CASMPostol/CFIS/DIB/GS-CO.BMP

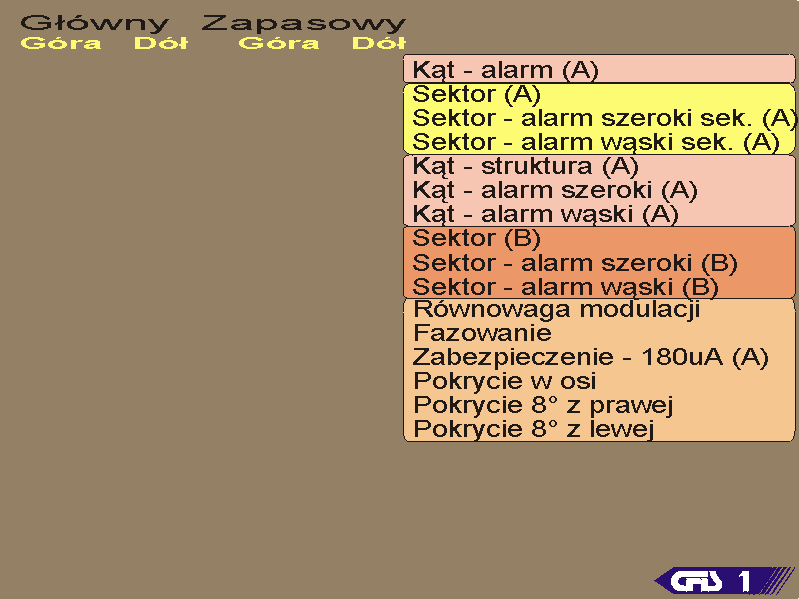
DIB/GS-CO.BMP
