CASMPostol/CFIS/DIB/LOC-CO.BMP

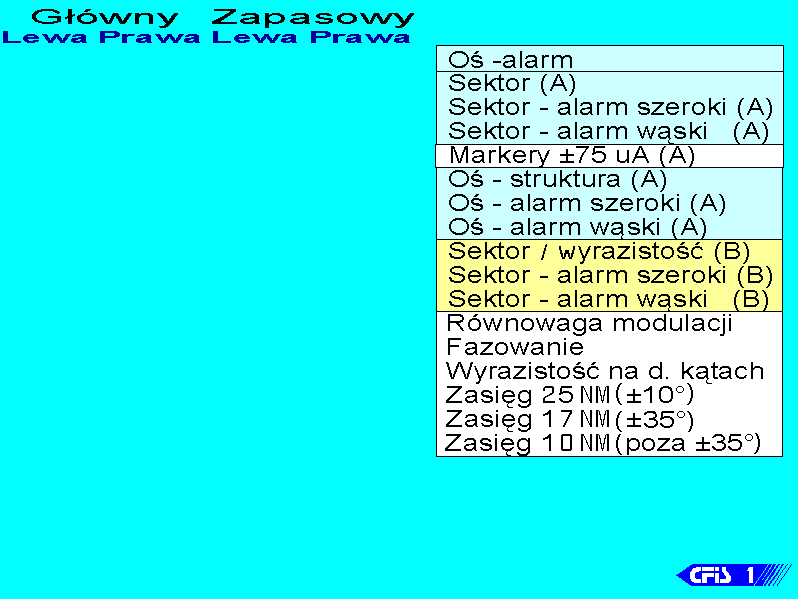
DIB/LOC-CO.BMP
