CASMPostol/CFIS/DIB/NDB-CO.BMP

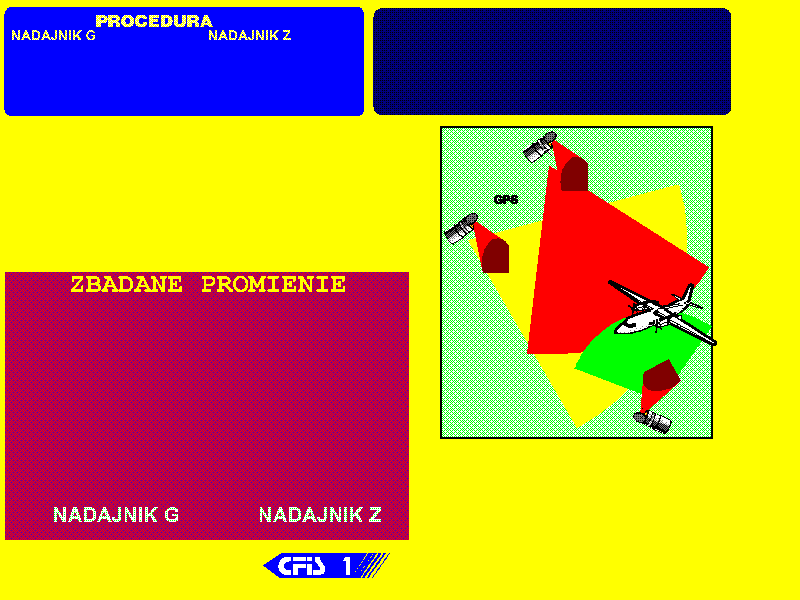
DIB/NDB-CO.BMP
