CASMPostol/CFIS/DIB/PK.BMP

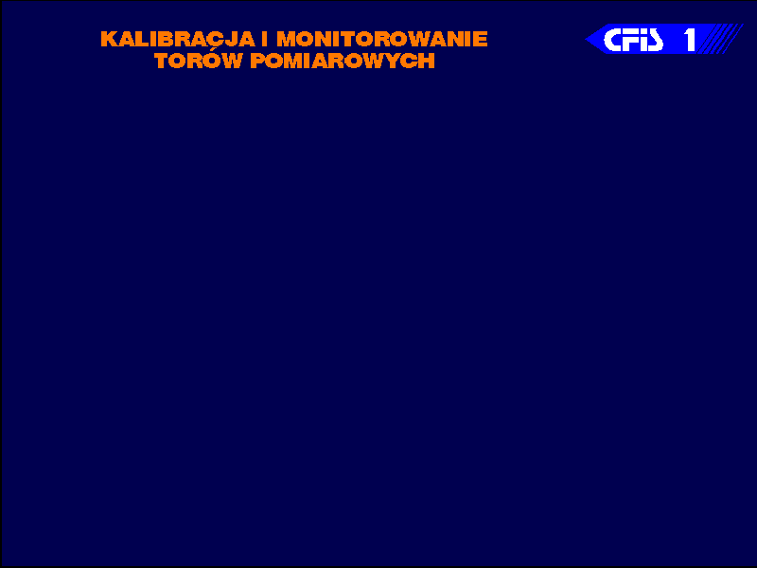
DIB/PK.BMP
