CASMPostol/CFIS/DIB/TRS-CO.BMP

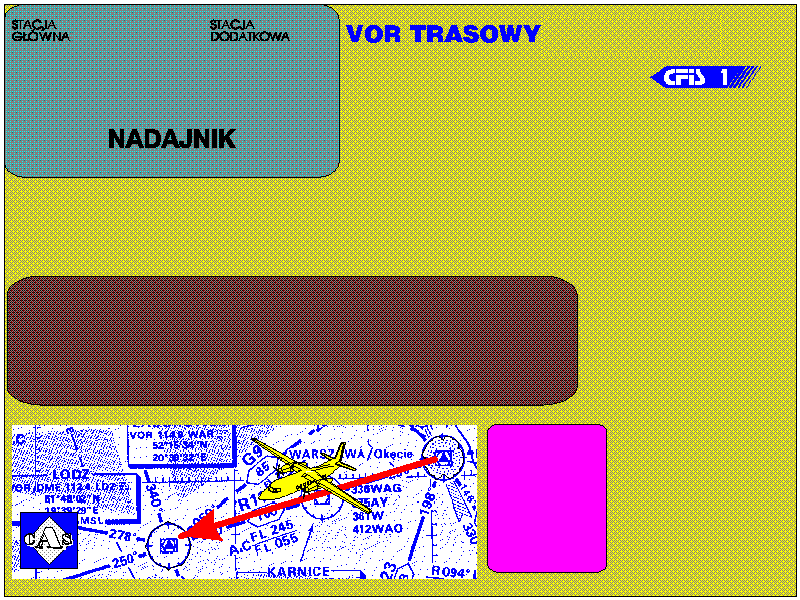
DIB/TRS-CO.BMP
