CASMPostol/CFIS/DIB/VOR-TYT.BMP

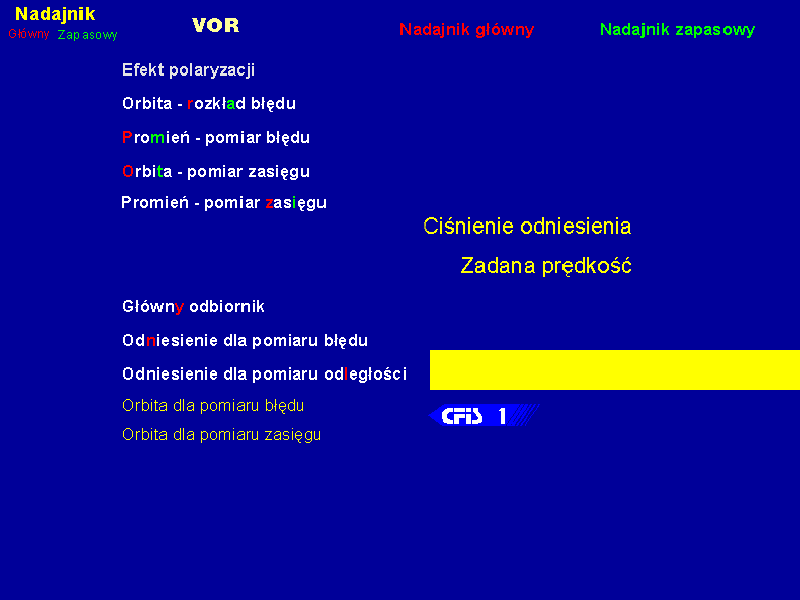
DIB/VOR-TYT.BMP
