CASMPostol/CFIS/DIB/VORA-TYT.BMP

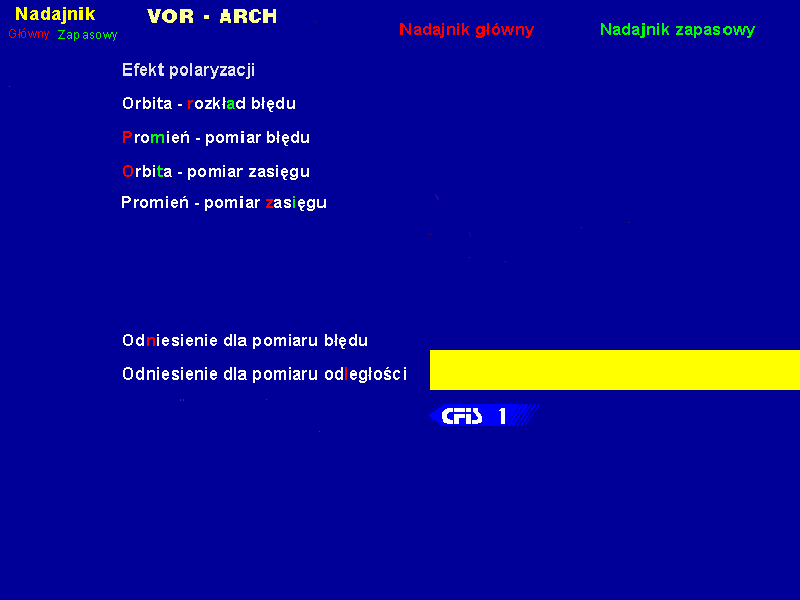
DIB/VORA-TYT.BMP
