CASMPostol/CFIS/docs/media/CFIS.GPSLocator.png

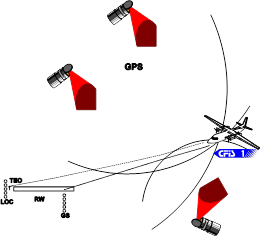
docs/media/CFIS.GPSLocator.png
