CASMPostol/CFIS/docs/media/cfis.jpg

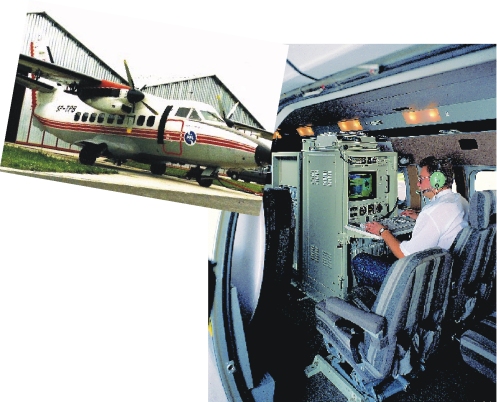
docs/media/cfis.jpg
