CASMPostol/CFIS/docs/media/samolot.jpg

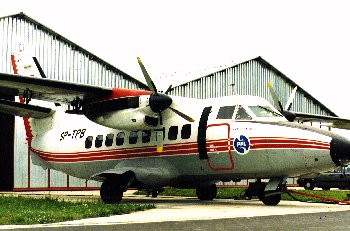
docs/media/samolot.jpg
