CASMPostol/CFIS/docs/media/Strona_tyt.jpg

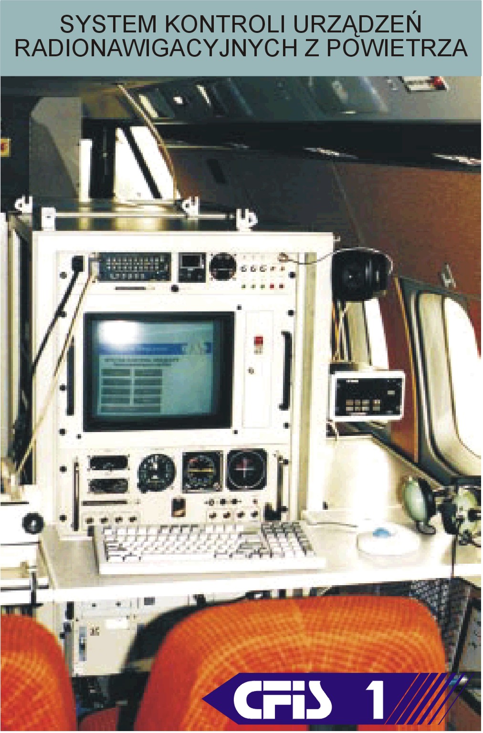
docs/media/Strona_tyt.jpg
