CASMPostol/CFIS/(list of files, cad)

Other CAD files:
docs/UserManual.pl/P-00010301-DokumentacjaTechniczna/Schematy_mechaniczne (ACAD)/SZAFA1(rys.1).dwg
docs/UserManual.pl/P-00010301-DokumentacjaTechniczna/Schematy_mechaniczne (ACAD)/SZAFA2 (rys.2).dwg
docs/UserManual.pl/P-00010301-DokumentacjaTechniczna/Schematy_mechaniczne (ACAD)/Schem. blok. ADF i VHF (rys.7).dwg
docs/UserManual.pl/P-00010301-DokumentacjaTechniczna/Schematy_mechaniczne (ACAD)/Rzut z przodu szafy 2 (rys.18).dwg
docs/UserManual.pl/P-00010301-DokumentacjaTechniczna/Schematy_mechaniczne (ACAD)/Schem. blok. ILS_VOR_MKR i DME(rys.6).dwg
docs/UserManual.pl/P-00010301-DokumentacjaTechniczna/Schematy_mechaniczne (ACAD)/Widok ogolny szafy 2 (rys.17).dwg
docs/UserManual.pl/P-00010301-DokumentacjaTechniczna/Schematy_mechaniczne (ACAD)/Wid. z gory rozm. szaf (rys.12).dwg
docs/UserManual.pl/P-00010301-DokumentacjaTechniczna/Schematy_mechaniczne (ACAD)/Wid. z boku pokladu sam. z zainst. szafami (rys.13).dwg
docs/UserManual.pl/P-00010301-DokumentacjaTechniczna/Schematy_mechaniczne (ACAD)/Rzut z boku szafy 2 (rys.19).dwg
docs/UserManual.pl/P-00010301-DokumentacjaTechniczna/Schematy_mechaniczne (ACAD)/Wid. pokl. sam. z zainst. szafami (rys.10).dwg
docs/UserManual.pl/P-00010301-DokumentacjaTechniczna/Schematy_mechaniczne (ACAD)/Widok ogolny szafy 1 (rys.14).dwg
docs/UserManual.pl/P-00010301-DokumentacjaTechniczna/Schematy_mechaniczne (ACAD)/Schem. blok. syst. komp. (rys.5).dwg
docs/UserManual.pl/P-00010301-DokumentacjaTechniczna/Schematy_mechaniczne (ACAD)/Wid. ogolny rozm. szaf (rys.11).dwg
docs/UserManual.pl/P-00010301-DokumentacjaTechniczna/Schematy_mechaniczne (ACAD)/Rack1(rys.3).dwg
docs/UserManual.pl/P-00010301-DokumentacjaTechniczna/Schematy_mechaniczne (ACAD)/Rack2 (rys.4).dwg
docs/UserManual.pl/P-00010301-DokumentacjaTechniczna/Schematy_mechaniczne (ACAD)/Rzut z boku szafy 1 (rys.16).dwg
docs/UserManual.pl/P-00010301-DokumentacjaTechniczna/Schematy_mechaniczne (ACAD)/Rzut z przodu szafy 1 (rys.15).dwg
docs/UserManual.pl/P-00010301-DokumentacjaTechniczna/Schematy_mechaniczne (ACAD)/Ogoly wid. pokl. samolotu w przekr. (rys.9).dwg
