CASMPostol/CFIS/docs/UserManual.pl/P-0001010101 - Podrecznik uzytkownika.pdf

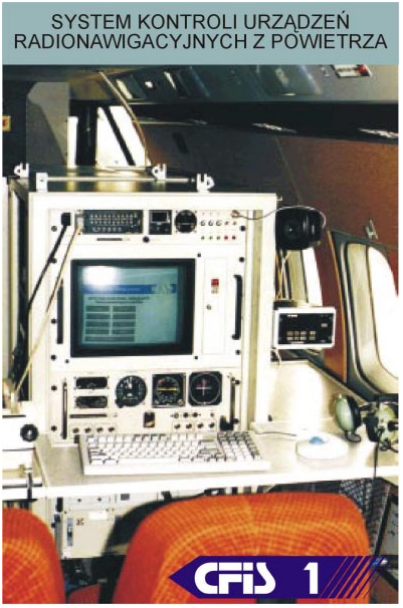
[picture p16: figure]

Łód stycze-

2002

## PROGRAM GŁÓWNY CFIS1

Copyright CAS

2002.
Edycja | 31
Dokument | F:\PROJEKTY\2000\00010151 - CFIS\DOKUMENTACJA\P-0001010101 -
| PODRECZNIK UZYTKOWNIKA.DOC
Data | 30-01-2002
Autorzy | Mgr in. Mariusz Postół (kierownik projektu)
Projekt | 99010151
Wersja | OSTATECZNA
Faza | Projekt techniczny
Inwestor
Załczniki do dokumentacji projektowej

### 1 Dokumenty zwi-

| zane: • SYSTEM TELEMETRI 6050D OPROGRAMOWANIE CAS V 1.00
| • DOKUMENTACJA TECHNICZNA, MODUŁY POMIAROWE,
| PRZEŁCZNIKI • ADF-CONTROL LOGIC
| • VHF- CONTROL LOGIC
| • NAV- CONTROL LOGIC
| • SWITCH
| • BADANIE TORÓW KALIBRACYJNYCH
| • PROGRAMY POMIAROWE I DANYCH ARCHIWALNYCH
| • PROGRAM KALIBRACYJNY
| • PROGRAM POMIAROWY I DANYCH ARCHIWALNYCH STACJI VOR NA
| TRASIE • PROGRAM POMIARU I DANYCH ARCHIWALNYCH KIERUNKU
| • PROGRAM POMIARU I DANYCH ARCHIWALNYCH STACJI NDB
| • PROGRAM BAZA DANYCH
| • PROGRAM POMIAROWY I DANYCH ARCHIWALNYCH STACJI
| VORPROGRAM POMIARU I DANYCH ARCHIWALNYCH CIEKI • SYSTEM KONTROLI URZDZE RADIONAWIGACYJNYCH
| • SYMULATOR SYSTEMÓW RADIONAWIGACYJNYCH
| • PODSTAWY DZIAŁANIA

CAS 94-104 Łód ul. Obywatelska 137
tel/fax: (42) 686 25 47; (42) 686 50 28 NIP: 727-001-85-68 www.cas.com.pl
mailto:techsupp@cas.com.pl

## SPIS TRECI

Instrukcja stanowiskowa

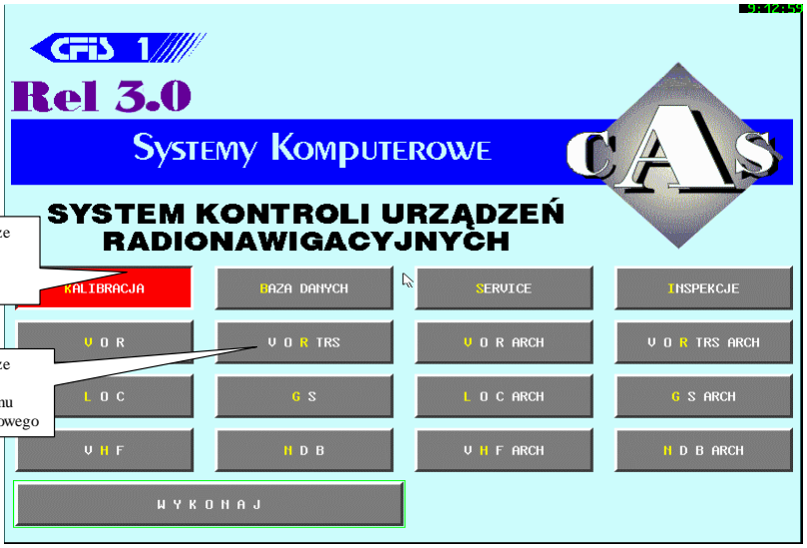
[picture p17: figure]

CAS 94-104 Łód ul. Obywatelska 137 | Strona: 1 | Wersja: 31/01/02

## WYKAZ PROGRAMÓW POMIAROWYCH

1. Program baza danych | Rev. 12/17-06-97
2. Program kalibracyjny | Rev. 24/18-06-97
3. Program pomiaru i danych archiwalnych stacji VOR | Rev. 13/17-06-97
4. Program pomiaru i danych archiwalnych stacji VOR na Trasie Rev. 10/17-06-97
5. Program pomiaru i danych archiwalnych kierunku | Rev. 27/17-06-97
6. Program pomiaru i danych archiwalnych cieki | Rev. 22/17-06-97
7. Program pomiaru i danych archiwalnych stacji NDB | Rev. 12/17-06-97
8. Program pomiaru i danych archiwalnych stacji VHF | Rev. 04/17-06-97
9. Symulator systemów radionawigacyjnych | Rev. 23/20-06-97

## PROGRAM GŁÓWNY

Program systemu kontroli urz-

dze radionawigacyjnych z powietrza rozpoczyna działanie oknem wyboru odpowiedniej funkcji - Rysunek 1 Okno główne programu systemu kontroli urzdze-
radionawigacyjnych z powietrza. Na ekranie pojawiaj- | si klawisze wyboru, które mona obsługiwa
zarówno za pomocmyszki jak i klawiatury.

Rysunek 1 Okno główne programu systemu kontroli urzdze-

radionawigacyjnych z powietrza

Po wybraniu myszk-

, klawisz zostaje podwietlony na czerwono. W celu zaakceptowania wyboru naley nacisnprzycisk „WYKONAJ”.

Klawisze
wyboru
funkcji

Klawisze
wyboru
programu
pomiarowego

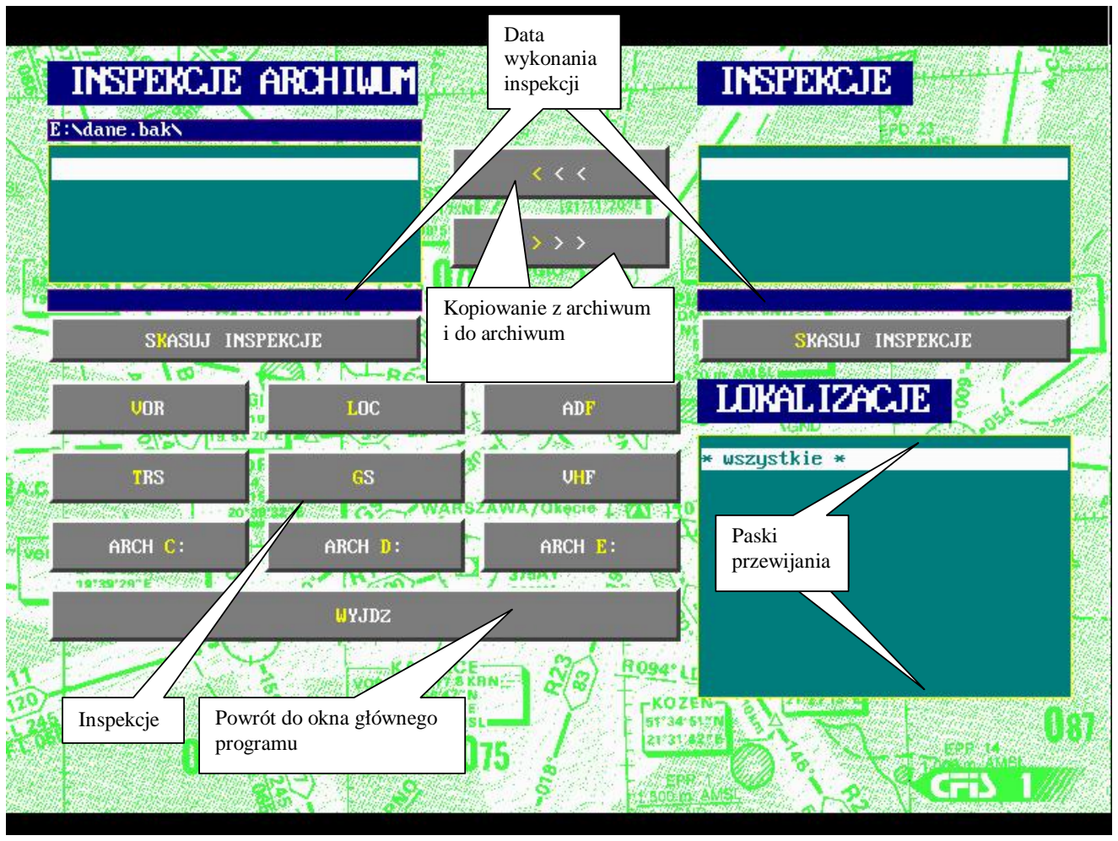
[picture p18: figure]
Paski przewijania; Klawisze umoliwiaj-; ce kopiowanie z archiwum i do archiwum; Data wykonania inspekcji; Powrót do okna głównego programu; Kopiowanie z archiwum i do archiwum; Inspekcje

CAS 94-104 Łód ul. Obywatelska 137 | Strona: 2 | Wersja: 31/01/02

Klawiatura pozwala na szybk-

obsług okna za pomoc-

klawiszy „Alt”+ litera podwietlona na ółto w klawiszach funkcji oraz klawiszach uruchomieniowych programów pomiarowych. W celu uruchomienia programu pomiarowego na danych archiwalnych, naley wcisnklawisz „Ctrl”+
wybran-

liter podwietlon-

na ółto. Wybór klawisza powoduje jego podwietlenie na czerwono, za potwierdzenie wyboru klawiszem „ENTER” przejcie do wybranego programu archiwalnego. Wybieraj-

c klawisz SERVICE przechodzi si do rodowiska MS-DOS, natomiast wybierajc
klawisz INSPEKCJE oraz akceptujc ten wybór klawiszem „ENTER” przechodzi si do okna INSPEKCJE Rysunek 2 Okno kopiowania danych archiwalnych Aby wyj

z programu naleyuy

połczenia klawiszy „Alt”+ klawisz funkcyjny F4.

Rysunek 2 Okno kopiowania danych archiwalnych

Okno INSPEKCJE umoliwia kopiowanie inspekcji z archiwum oraz do archiwum. Wybór klawiszy „ARCH C:”, „ARCH D:” oraz „ARCH E:” powoduje wywietlenie danych zarchiwizowanych na wymienionych dyskach.
Pomi dzy okienkiem INSPEKCJE ARCHIWUM a okienkiem INSPEKCJE znajdujsi klawisze
słu-

ce do kopiowania. Po wcini ciu jednego z tych klawiszy pojawia si okienko z zapytaniem „Chcesz skopiowa

:....?” oraz klawisze wyboru „TAK” oraz „NIE”. Jeeli skopiowanie zostało zaakceptowane pojawia si kolejne okienko „Inspekcja skopiowana pomylnie” w okienku tym naley wcisnklawisz

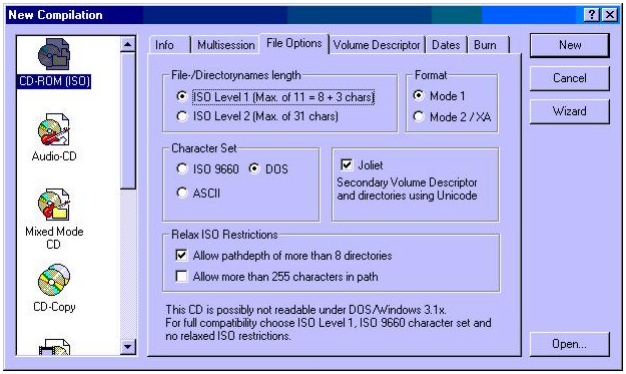
[picture p19: figure]

CAS 94-104 Łód ul. Obywatelska 137 | Strona: 3 | Wersja: 31/01/02

„kontynuacja”.
Pod okienkiem INSPEKCJE ARCHIWUM oraz INSPEKCJE znajduj-

si klawisze słuce do
skasowania inspekcji. Po wcini ciu tego klawisza pojawia si okienko z zapytaniem „Jeste pewien, e chcesz usuninspekcj ?” i klawisz „TAK” oraz „NIE”. Po zaakceptowaniu skasowania pojawia si kolejne okienko „Inspekcja zostanie usuni ta...” oraz klawisze „TAK”, „NIE”. Nast pnie na ekranie pojawia si okienko „Inspekcja usuni ta pomylnie” w okienku tym naley wcisnklawisz „kontynuacja”.
W celu powrotu do okna rozpoczynaj-

cego program naley wcisn-

klawisz „WYJD” lub uy
połczenia klawiszy „Alt” oraz klawisza funkcyjnego F4.

## OPROGRAMOWANIE DO NAGRYWARKI CD-ROM

Do stacji „SODA” zamontowana została nagrywarka CD-ROM. Dla jej właciwej pracy wymagane jest zainstalowanie oprogramowania NERO dostarczonego wraz z urzdzeniem.
Instalacja oprogramowania „NERO” przebiega w sposób standardowy dla aplikacji pracujcych w
systemie WINDOWS. Podczas instalacji naley wykonywa
polecenia zgodnie z zaleceniami programu instalacyjnego. Po pomylnie zakoczonej instalacji naley wej
w okno „New Compilation” w celu ustawienia standardu zapisywania plików i katalogów. Ustawienia tego okna powinny przedstawia

si jak
na Rysunek 3 Okno konfiguracyjne oprogramowania „NERO”.

Rysunek 3 Okno konfiguracyjne oprogramowania „NERO”
