CASMPostol/CFIS/docs/UserManual.pl/p-0001010701-baza danych.pdf

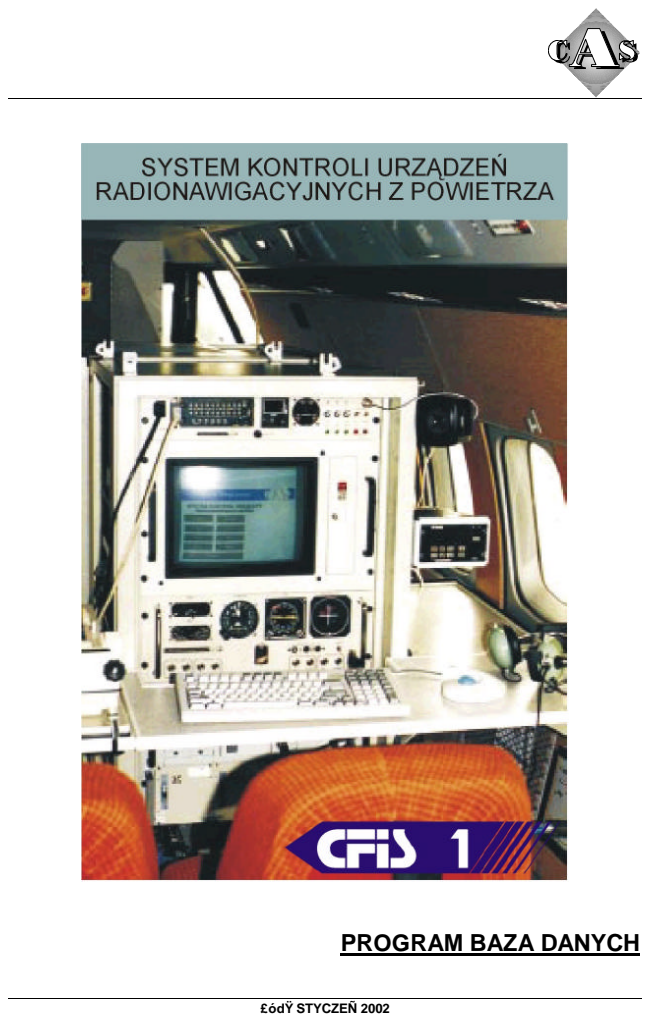
[picture p20: page 1]
£ódŸ STYCZEÑ 2002

PROGRAM BAZA DANYCH

Copyright C.A.S.

2002.

Edycja: 20
Wersja: ostateczna

CAS 94-104 £ódŸ ul. Obywatelska 137
tel/fax: (42) 686 25 47; (42) 686 50 28 NIP: 727-001-85-68 www.cas.com.pl
mailto:techsupp@cas.com.pl

P-0001010701 - Baza danych | i | Edycja 20

# SPIS TREO CI

# WSTÊP

## Baza danych

Program ten umo¿liwia wprowadzanie do bazy danych informacji o naziemnych urz¹dzeniach nawigacyjnych oraz modyfikacjê ich parametrów. Bazê danych stanowi plik zawieraj¹cy informacje o infrastrukturze naziemnej urz¹dzeñ nawigacyjnych potrzebnej przy wykonywaniu pomiarów inspekcyjnych. Zawiera on m. in. po³o¿enie urz¹dzeñ nawigacyjnych oraz podstawowe parametry z nimi zwi¹zane (np. nazwa urz¹dzenia, czêstotliwoœæ nadawania itp.). Informacje zawarte w bazie danych wykorzystywane s¹ przez programy pomiarowe w czasie tworzenia inspekcji pomiarowych. Mo¿liwoœæ ingerencji w bazê danych powoduje ¿e programy pomiarowe staj¹ siê bardziej uniwersalny. Zmiany i modyfikacje zawartych w programie parametrów mog¹ byæ dokonywane dla urz¹dzeñ:

∗ VOR
∗ Urz¹dzeñ nawigacyjnych lotnisk (ILS, DME, MARKER)
∗ NDB
∗ VHF

### Baza danych zawiera równie¿ listê inspektorów lotniczych uprawnionych do prowadzenia pomiarów, firmuj¹cych swoim nazwiskiem raport dopuszczaj¹cy dane urz¹dzenie do

eksploatacji.

## Zasady korzystania z klawiatury i Trackball-a

### Program mo¿e byæ obs³ugiwany za pomoc¹ klawiatury lub trackball-a. Trackball-a reprezentuje na ekranie kursor œwietlny. Poszczególne okna danych i przyciski mog¹ byæ

uruchamiane za pomoc¹ trackball-a lub przy pomocy klawiatury.

### Obs³uga wyboru urz¹dzenia Uruchomienie wybranej opcji nastêpuje poprzez naciœniêcie kombinacji klawiszy j¹ reprezentuj¹cych opisanych na czerwono lub przez bezpoœrednie najechanie kursorem

trackball-a i pojedyncze „klikniêcie”. Jeœli chodzi o pasek menu g³ównego uruchomiæ wybran¹

opcjê mo¿na przez naciœniêcie klawiszy Alt + litera zaznaczona na czerwono w menu g³ównym. Do menu g³ównego mo¿na równie¿ siê dostaæ (bez uruchomienia ¿adnej opcji) poprzez naciœniêcie klawisza funkcyjnego F10. Spowoduje to, ¿e opcja menu g³ównego zostanie podœwietlona na zielono. Naciœniêcie klawisza Enter spowoduje rozwiniêcie podœwietlonej podopcji menu g³ównego. W rozwiniêciu aktualna podopcja podœwietlona bêdzie na zielono. Zmianê aktualnej podopcji dokonujemy klawiszami kursorów klawiatury (zielone podœwietlenie bêdzie siê przesuwa³o). Uruchomienie aktualnej podopcji nastêpuje poprzez naciœniêcie klawisza Enter. Podopcje mo¿emy uruchomiæ tak¿e poprzez naciœniêcie kombinacji klawiszy j¹ reprezentuj¹cych opisanych na czerwono lub przez bezpoœrednie

najechanie kursorem trackball-a i pojedyncze „klikniêcie”.

### Parametry radiolatarni

Wybór radiolatarni
Nazwa aktualnego nadajnika znajduje siê w OKNIE „NADAJNIKA” (domyœlnie VOR,

NDB, VHF, ILS), jego te¿ parametry przedstawione s¹ poni¿ej. Zmianê aktualnego nadajnika dokonujemy poprzez wprowadzenie nowego nadajnika o czym bêdzie mowa w rozdziale Wprowadzanie nowego nadajnika i poprzez zast¹pienie aktualnego nadajnika nowym z listy nadajników znajduj¹cych siê w bazie danych. Naciskaj¹c przycisk Ú spowodujemy wyœwietlenie listy nadajników znajduj¹cych siê w bazie danych. Aktualny nadajnik podœwietlony jest zielonym kursorem. Dokonuj¹c przemieszczenia kursora powodujemy zmianê aktualnego nadajnika. Przemieszczenia mo¿emy dokonaæ naciskaj¹c klawisze kursorów

Wstêp

P-0001010701 - Baza danych | 2 | Edycja 20

### klawiatury, naje¿d¿aj¹c kursorem trackball-a na nazwê nadajnika, który ma byæ aktualny i

„klikaj¹c” jednokrotnie i naje¿d¿aj¹c kursorem i „klikaj¹c” na przyciski Ú Ù które powoduj¹ przemieszczanie zielonego kursora. Swoj¹ decyzjê zatwierdzamy naciskaj¹c klawisz Enter lub

### naje¿d¿aj¹c kursorem trackball-a na przycisk • znajduj¹cy siê w lewym górnym rogu listy nadajników i „klikaj¹c”. Zamkniêcie okna mo¿na te¿ spowodowaæ kombinacj¹ klawiszy ALT+F3. Po zatwierdzeniu program wraca do okna przedstawiaj¹cego aktualny nadajnik wraz

z jego parametrami.
Modyfikacja parametrów

### Zmianê parametrów aktualnego nadajnika (w³¹cznie z jego nazw¹) dokonujemy poprzez najechanie znacznikiem kursora na odpowiednie okno i pojedyncze „klikniêcie”. W oknie

uaktualniony zostanie kursor. Kasuj¹c za pomoc¹ klawisza backspace ← lub delete znajduj¹c¹ siê tam informacjê, w utworzone w ten sposób puste miejsce wpisujemy now¹ informacjê.

Wpisan¹ tam informacje zatwierdzamy naciskaj¹c klawisz Enter, Tab lub wybieraj¹c kursorem Trackball-a nowy parametr i pojedynczo „klikaj¹c”. Kasowane mog¹ byæ równie pojedyncze znaki bez kasowania ca³ej informacji. Przemieszczenia miêdzy poszczególnymi oknami danych mo¿e byæ dokonane tak¿e przez naciskanie klawisza Tab. Spowoduje on przemieszczanie pomiêdzy kolejnymi oknami danych zielonego kursora. Zielony kursor mo¿na przemieœciæ do wybranego okna naciskaj¹c kombinacje klawiszy Alt + podœwietlona na ¿ó³to litera z nazwy opisuj¹cej okno. Po umieszczeniu kursora w oknie zawieraj¹cym dane, które maj¹ zostaæ zmienione nale¿y wpisaæ z klawiatury ich now¹ wartoœæ. Zatwierdzenie wprowadzonych danych nastêpuje poprzez naciœniêcie klawisza Enter lub Tab. Istniej¹ równie¿ parametry których brak lub wystêpowanie zaznaczone jest znakiem X. Operacjê wprowadzenia tego znacznika przeprowadzamy podœwietlaj¹c pole, w którym bêdzie wystêpowa³ jedn¹ z

opisanych powy¿ej metod i naciœniêcie przycisku spacji.
Promienie

### W ramach obs³ugi danych nadajnika VOR i NDB wystêpuje przycisk Dodaj. Pozwala na dodanie nowego promienia do ju¿ wystêpuj¹cej listy promieni. Po jego uruchomieniu na ekranie dodatkowo uka¿¹ siê:

∗ przycisk • - powoduje wyjœcie z procedury
∗ okno DANYCH - s³u¿¹ce do wpisania nowej wartoœci promienia,
∗ przycisk Ok - powoduj¹cy zatwierdzenie nowej wartoœci promienia,
∗ przycisk Cancel - powoduj¹cy zrezygnowanie z wprowadzania nowego promienia.

### Wymienione wy¿ej okno i przyciski s¹ jedynymi mo¿liwymi do wyboru w ramach

uruchomienia przycisku Dodaj.

### W oknie DANYCH wpisujemy now¹ wartoœæ promienia z przedzia³u od 0° do 359°. Inne

wartoœci, liczby nieca³kowite i litery nie zostan¹ przyjête przez program. Po wpisaniu wartoœci

### promienia symbolu jednostki [°] nie dodajemy zostanie ona wprowadzona automatycznie przez

program.

### Przycisk Ok powoduje zatwierdzenie nowego promienia, dodanie go do listy promieni

nadajnika g³ównego i zapasowego oraz powrót do ekranu parametrów nadajnika.

### Przycisk Cancel powoduje zrezygnowanie z wprowadzania nowego promienia i powrót do

ekranu parametrów nadajnika.

### Usuniêcia promienia dokonujemy poprzez „naciœniêcie” przycisku Usuñ. Usuniêty zostanie

promieñ aktualny, który podœwietlony jest na zielono.
Wprowadzanie nowego nadajnika

### Wprowadzenie nowego nadajnika do bazy danych odbywa siê poprzez podœwietlenie napisu

aktualnego nadajnika jedn¹ z metod opisanych przy opisie procedury Modyfikacja parametrów.

### A nastêpnie wprowadzenie z klawiatury nowej nazwy nadajnika. Zatwierdzenie nowej nazwy

Wybór opcji

P-0001010701 - Baza danych | 3 | Edycja 20

### odbywa siê poprzez naciœniêcie klawisza Tab, Enter. Po zatwierdzeniu wprowadzony nowy nadajnik stanie siê nadajnikiem aktualnym wszystkie parametry opisuj¹ce go zostan¹ wyzerowane. Nale¿y wprowadziæ ich prawdziwe wartoœci wed³ug procedury Modyfikacja

parametrów.
Usuniêcie nadajnika

### Nale¿y nadajnikowi, który ma zostaæ usuniêty, nadaæ status aktualnego, a nastêpnie

„naciskaj¹c” przycisk Usuñ z bazy danych spowodowaæ jego usuniêcie z bazy danych.
Lista odpowiedzialnych

### W ramach obs³ugi menu Lista odpowiedzialnych wystêpuje przycisk Dodaj. Pozwala on na dodanie danych nowego inspektora do ju¿ wystêpuj¹cej listy odpowiedzialnych za pomiar. Po jego uruchomieniu na ekranie dodatkowo uka¿¹ siê:

∗ przycisk • - powoduje wyjœcie z procedury
∗ okno DANYCH - s³u¿¹ce do wpisania danych inspektora
∗ przycisk Ok - powoduj¹cy zatwierdzenie nowego inspektora
∗ przycisk Cancel - powoduj¹cy zrezygnowanie z wprowadzania danych nowego inspektora.

### Wymienione wy¿ej okno i przyciski s¹ jedynymi mo¿liwymi do wyboru w ramach

uruchomienia przycisku Dodaj.

### W oknie DANYCH wpisujemy dane inspektora uprawnionego do prowadzenia pomiarów

naziemnych urz¹dzeñ nawigacyjnych. D³ugoœæ informacji nie mo¿e przekraczaæ 30 znaków.

### Przycisk Ok powoduje zatwierdzenie danych nowego inspektora i dodanie go do listy

odpowiedzialnych za pomiar.

### Przycisk Cancel powoduje zrezygnowanie z wprowadzania danych nowego inspektora

i powrót do listy odpowiedzialnych.

### Usuniêcia inspektora z listy odpowiedzialnych dokonujemy poprzez „naciœniêcie” przycisku

Usuñ. Usuniêty zostanie inspektor, którego dane podœwietlone s¹ na zielono.
Koniec procedury

### Ka¿d¹ procedurê koñczymy naciskaj¹c kombinacjê klawiszy Alt F3 lub „naciskaj¹c”

przycisk •. Koniec programu nastêpuje po naciœniêciu kombinacji klawiszy Alt + Q.

# WYBÓR OPCJI

### Po uruchomieniu programu Baza Danych na monitorze pojawi siê ekran wyboru urz¹dzenia. W tej czêœci programu u¿ytkownik ma mo¿liwoœæ wyboru urz¹dzenia, którego

dane bêd¹ modyfikowane lub, które zostanie na nowo zdefiniowane w bazie danych.

### Na ekranie znajduje siê : Pasek menu rozwijanego, znajduj¹cy siê w górnej czêœci ekranu, zawieraj¹cy:

∗ Urz¹dzenia - w rozwiniêciu tej opcji zawarta jest lista dostêpnych urz¹dzeñ.

### Pasek z przyciskami funkcyjnymi, zawieraj¹cy:

∗ Alt + Q Koniec - powoduje wyjœcie z programu
∗ Ctrl + V VOR - powoduje przejœcie do modyfikacji parametrów nadajników VOR
∗ Ctrl + L Lotn. - powoduje przejœcie do modyfikacji parametrów nadajników nawigacyjnych wystêpuj¹cych na lotnisku
∗ Alt + F3 Zamknij - niedostêpne w tej czêœci programu

### Po uruchomieniu opcji Urz¹dzenia zostanie rozwiniête podmenu tej opcji zawieraj¹ce:

∗ VOR Ctrl + V - powoduje przejœcie do modyfikacji parametrów nadajników VOR
∗ Lotnisko Ctrl + L - powoduje przejœcie do modyfikacji parametrów nadajników nawigacyjnych wystêpuj¹cych na lotnisku
∗ VHF Ctrl + H - powoduje przejœcie do modyfikacji parametrów nadajników VHF
∗ NDB Ctrl + N - powoduje przejœcie do modyfikacji parametrów nadajników NDB
∗ Lista odpowiedzialnych - powoduje przejœcie do opcji zmian w liœcie inspektorów

VOR

P-0001010701 - Baza danych | 4 | Edycja 20

∗ Koniec Alt + Q - powoduje wyjœcie z programu

### Po dokonaniu wyboru przechodzimy do modyfikacji parametrów urz¹dzenia lub

wychodzimy z programu.

# VOR

### Po uruchomieniu tej opcji na ekranie pojawi siê okno na którym znajd¹ siê nastêpuj¹ce parametry opisuj¹ce nadajnik VOR, a tak¿e przyciski funkcyjne:

∗ przycisk • - powoduj¹cy powrót do ekranu wyboru urz¹dzenia
∗ OKNO VOR - znajdowaæ siê w nim bêdzie nazwa aktualnego nadajnika VOR, którego opis przedstawiony jest poni¿ej
∗ przycisk Ú - powoduje uaktywnienie okna z list¹ nadajników VOR aktualnie znajduj¹cych siê w bazie danych
∗ okno ‘Czêst.’ - znajduje siê w nim czêstotliwoœæ aktualnego nadajnika VOR w [MHz]
∗ okno ‘Szerokoœæ’ - znajduje siê w nim szerokoœæ geograficzna aktualnego nadajnika VOR w [stopnie.minuty.tysiêczne minuty]
∗ okno ‘D³ugoœæ’ - znajduje siê w nim d³ugoœæ geograficzna aktualnego nadajnika VOR w [stopnie.minuty.tysiêczne minuty]
∗ okno ‘Deklinacja’ - znajduje siê w nim odchylenie bieguna magnetycznego dla po³o¿enia aktualnego nadajnika VOR w [°]
∗ parametry okreœlaj¹ce po³o¿enie Teodolitu wzglêdem aktualnego nadajnika VOR
- okno ‘Odleg³oœæ’ - znajduje siê w nim odleg³oœæ Teodolitu wyra¿ona w [m]
- okno ‘K¹t’ - znajduje siê w nim k¹t ustawienia Teodolitu wyra¿ony w [°]
∗ okno ‘Orb. pomiar’ - znajduje siê w nim promieñ orbity dla pomiaru b³êdu namiaru dla aktualnego nadajnika VOR wyra¿ona w [NM]
∗ okno ‘Orb. zasiêg’ - znajduje siê w nim promieñ orbity dla pomiaru zasiêgu dla aktualnego nadajnika VOR wyra¿ona w [NM]
∗ okno ‘Identyfikator’ - znajduje siê w nim trzy literowy identyfikator aktualnego nadajnika VOR
∗ pole znacznika DME - X oznacza ¿e wraz z aktualnym nadajnikiem VOR wystêpuje nadajnik DME ∗ okno PROMIENIE - znajduj¹ siê w nim promienie aktualnego nadajnika VOR wyra¿one w [°]
∗ przycisk Dodaj - powoduje dodanie nowego promienia w oknie PROMIENIE
∗ przycisk Usuñ - powoduje usuniêcie podœwietlonego promienia z okna PROMIENIE
∗ przycisk Usuñ z bazy danych - powoduje usuniêcie aktualnego nadajnika VOR z bazy danych
∗ okno GPS s³u¿¹ce do inicjacji odbiornika referencyjnego GPS. W nowej wersji programu okno to nie jest u¿ywane
Po dokonaniu modyfikacji z opcji wychodzimy jedna ze znanych metod.

# LOTNISKO

### Po uruchomieniu tej opcji na ekranie pojawi siê okno na którym znajd¹ siê parametry

opisuj¹ce urz¹dzenia nawigacyjne Lotniska, a tak¿e przyciski funkcyjne. Znajdowaæ siê w nim

### bêd¹:

∗ przycisk • - powoduj¹cy powrót do ekranu wyboru urz¹dzenia
∗ OKNO ILS - nazwa aktualnego nadajnika ILS, którego opis przedstawiony jest poni¿ej
∗ przycisk Ú - powoduje uaktywnienie okna z list¹ nadajników ILS aktualnie znajduj¹cych siê w bazie danych
∗ okno ‘Czêst (ch)’ - znajduje siê w nim kana³ oraz czêstotliwoœæ aktualnego nadajnika ILS w [MHz] ∗ przycisk Ú - powoduje uaktywnienie okna z list¹ czêstotliwoœci dostêpnych dla danego nadajnika
∗ okno ‘Szerokoœæ’ - znajduje siê w nim szerokoœæ geograficzna po³o¿enia nadajnika ILS w [stopnie.minuty.tysiêczne minuty]
∗ okno ‘D³ugoœæ’ - znajduje siê w nim d³ugoœæ geograficzna po³o¿enia aktualnego nadajnika ILS w [stopnie.minuty.tysiêczne minuty]
∗ parametry okreœlaj¹ce po³o¿enie Teodolitu wzglêdem aktualnego nadajnika ILS
- okno ‘Odl.GS’ - znajduje siê w nim odleg³oœæ Teodolitu od anten œcie¿ki wyra¿ona w [m]

VHF

P-0001010701 - Baza danych | 5 | Edycja 20
- okno ‘Odl.Loc’ - znajduje siê w nim odleg³oœæ Teodolitu od anten kierunku wyra¿ona w [m] ∗ parametry pasa lotniska
- okno ‘Kier. pasa’ - wyra¿ony w [°]
- okno ‘Próg’ - wyra¿ony w [NM]
- okno ‘Koniec’ - wyra¿ony w [NM]
∗ parametry okreœlaj¹ce po³o¿enie markerów wzglêdem anten aktualnego nadajnika ILS liczone od progu pasa
- okno ‘Wewnêtrzny’ - znajduje siê w nim odleg³oœæ wewnêtrznego markera wyra¿ona w [NM]
- okno ‘Œrodkowy’ - znajduje siê w nim odleg³oœæ œrodkowego markera wyra¿ona w [NM]
- okno ‘Zewnêtrzny’ - znajduje siê w nim odleg³oœæ zewnêtrznego markera wyra¿ona w [NM] ∗ parametry okreœlaj¹ce œcie¿kê schodzenia
- okno ‘Szerokoœæ’ - znajduje siê w nim szerokoœæ sektora œcie¿ki schodzenia wyra¿ona w [°]
- okno ‘K¹t’ - znajduje siê w nim k¹t œcie¿ki schodzenia wyra¿on¹ w [°]
∗ okno ‘Kategoria’ - okreœlaj¹ce kategoriê lotniska
∗ okno ‘Identyf’ - znajduje siê w nim trzyliterowy skrót identyfikuj¹cy nadajnik ILS
∗ pole znacznika DME - X oznacza ¿e wraz z aktualnym nadajnikiem ILS wystêpuje nadajnik DME ∗ parametry nadajnika DME wzglêdem nadajnika ILS
- okno ‘Szerokoœæ’ - znajduje siê w nim szerokoœæ geograficzna po³o¿enia nadajnika DME w [stopnie.minuty.tysiêczne minuty]
- okno ‘D³ugoœæ’ - znajduje siê w nim d³ugoœæ geograficzna po³o¿enia aktualnego nadajnika DME w [stopnie.minuty.tysiêczne minuty]
- okno ‘Offset’ - znajduje siê w nim offset nadajnika DME wyra¿ony w [NM]
∗ okno ‘Szerokoœæ sektora kierunku’ - znajduje siê w nim szerokoœæ sektora wyra¿ona w [°]
∗ parametry alarmów
- okno ‘W¹ski’ - szerokoœæ sektora dla alarmu w¹skiego wyra¿ona w [°]
- okno ‘Szeroki’ - szerokoœæ sektora dla alarmu szerokiego wyra¿ona w [°]
∗ po³o¿enie punktów charakterystycznych wzglêdem anten aktualnego nadajnika ILS liczone od progu pasa
- okno ‘- = > A’ - znajduje siê w nim po³o¿enie punktu A w [NM]
- okno ‘- = > B’ - znajduje siê w nim po³o¿enie punktu B w [NM]
- okno ‘- = > C’ - znajduje siê w nim po³o¿enie punktu C w [NM]
- okno ‘- = > D’ - znajduje siê w nim po³o¿enie punktu D w [NM]
- okno ‘- = > E’ - znajduje siê w nim po³o¿enie punktu E w [NM]
∗ przycisk Usuñ z bazy danych - powoduje usuniêcie aktualnego Lotniska z bazy danych
∗ okno GPS s³u¿¹ce do inicjacji odbiornika referencyjnego GPS. W nowej wersji programu okno to nie jest u¿ywane
Po dokonaniu modyfikacji z opcji wychodzimy jedn¹ ze znanych metod.

# VHF

### Po uruchomieniu tej opcji na ekranie pojawi siê okno na którym znajd¹ siê parametry opisuj¹ce nadajnik VHF, a tak¿e przyciski funkcyjne. Znajdowaæ siê w nim bêd¹:

∗ przycisk • - powoduj¹cy powrót do ekranu wyboru urz¹dzenia
∗ OKNO VHF - znajdowaæ siê w nim bêdzie nazwa aktualnego nadajnika VHF, którego opis przedstawiony jest poni¿ej
∗ przycisk Ú - powoduje uaktywnienie okna z list¹ nadajników VHF aktualnie znajduj¹cych siê w bazie danych
∗ okno ‘Szerokoœæ’ - znajduje siê w nim szerokoœæ geograficzna aktualnego nadajnika VHF w [stopnie.minuty.tysiêczne minuty]
∗ okno ‘D³ugoœæ’ - znajduje siê w nim d³ugoœæ geograficzna aktualnego nadajnika VHF w [stopnie.minuty.tysiêczne minuty]
∗ okno ‘Deklinacja’ - znajduje siê w nim odchylenie bieguna magnetycznego dla po³o¿enia aktualnego nadajnika VHF w [°]
∗ okno GPS s³u¿¹ce do inicjacji odbiornika referencyjnego GPS. W nowej wersji programu okno to nie jest u¿ywane

NDB

P-0001010701 - Baza danych | 6 | Edycja 20

∗ przycisk Usuñ z bazy danych - powoduje usuniêcie aktualnego nadajnika VHF z bazy danych Po dokonaniu modyfikacji z opcji wychodzimy jedna ze znanych metod.

# NDB

### Po uruchomieniu tej opcji na ekranie pojawi siê okno na którym znajd¹ siê parametry opisuj¹ce nadajnik NDB, a tak¿e przyciski funkcyjne. Znajdowaæ siê w nim bêd¹:

∗ przycisk • - powoduj¹cy powrót do ekranu wyboru urz¹dzenia
∗ OKNO NDB - znajdowaæ siê w nim bêdzie nazwa aktualnego nadajnika NDB, którego opis przedstawiony jest poni¿ej
∗ przycisk Ú - powoduje uaktywnienie okna z list¹ nadajników NDB aktualnie znajduj¹cych siê w bazie danych
∗ okno ‘Czêst.’ - znajduje siê w nim czêstotliwoœæ aktualnego nadajnika NDB w [kHz]
∗ okno ‘Szerokoœæ’ - znajduje siê w nim szerokoœæ geograficzna aktualnego nadajnika NDB w [stopnie.minuty.tysiêczne minuty]
∗ okno ‘D³ugoœæ’ - znajduje siê w nim d³ugoœæ geograficzna aktualnego nadajnika NDB w [stopnie.minuty.tysiêczne minuty]
∗ okno ‘Deklinacja’ - znajduje siê w nim odchylenie bieguna magnetycznego dla po³o¿enia aktualnego nadajnika NDB w [°]
∗ okno ‘Identyf’ - znajduje siê w nim trzyliterowy skrót identyfikuj¹cy nadajnik NDB
∗ okno GPS s³u¿¹ce do inicjacji odbiornika referencyjnego GPS. W nowej wersji programu okno to nie jest u¿ywane
∗ przycisk Usuñ z bazy danych - powoduje usuniêcie aktualnego nadajnika NDB z bazy danych
Po dokonaniu modyfikacji z opcji wychodzimy jedn¹ z opisanych poprzednio metod.

# LISTA ODPOWIEDZIALNYCH

### Po uruchomieniu tej opcji na ekranie pojawi siê okno na którym znajd¹ siê dane personalne inspektorów odpowiedzialnych za wykonywanie pomiarów naziemnych urz¹dzeñ nawigacyjnych i firmuj¹cych swym nazwiskiem dopuszczenie ich do u¿ytku, a tak¿e przyciski funkcyjne:

∗ przycisk • - powoduj¹cy powrót do ekranu wyboru urz¹dzenia
∗ OKNO INSPEKTORÓW - znajdowaæ siê bêd¹ dane personalne inspektorów
∗ przycisk Dodaj - powoduje dodanie nowego inspektora do Listy odpowiedzialnych za pomiar ∗ przycisk Usuñ - powoduje usuniêcie inspektora z Listy odpowiedzialnych za pomiar
Po dokonaniu modyfikacji z opcji wychodzimy jedna z opisanych metod.
