CASMPostol/CFIS/docs/UserManual.pl/P-00010602-Analiza FAA8240.36F.pdf

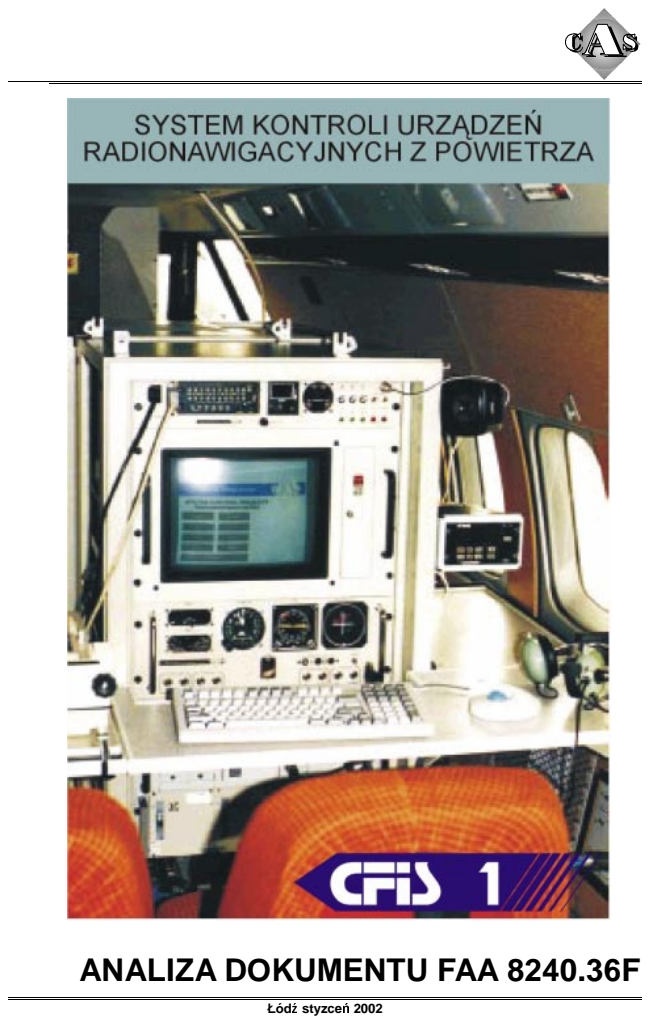
[picture p21: page 1]
Łód styzce-

ANALIZA DOKUMENTU FAA 8240.36F

Copyright CAS

2002.
Utwór w całoci ani we fragmentach nie moe by powielany ani rozpowszechniany za pomoc urzdze elektronicznych, mechanicznych, kopiujcych, nagrywajcych i innych bez pisemnej zgody posiadacza praw autorskich.
Edycja | 11
Dokument | P-00010602-ANALIZA FAA8240.36F
Data | 04-02-02
Autorzy | Mgr in. Mariusz Postół (kierownik projektu)
Projekt | P-00010602
Wersja | OSTATECZNA
Faza | Dokumentacja powykonawcza
Inwestor | PP Porty Lotnicze
Dokumenty zwizane
1 Instruction for Flight Inspection Reporting, Department of Transportation FAA, September 3, 1997, Order: 8240.36F

CAS
94-104 Łód ul. Obywatelska 137 tel/fax: (42) 686 25 47; (42) 686 50 28 www.cas.com.pl
mailto:techsupp@cas.com.pl

## SPIS TRECI

Wstp

CAS 94-104 Łód ul. Obywatelska 137 | Strona: 1 | Dokument: P-00010602/Edycja: 11

## 1. WST-

P

Dokumentacja została opracowana na podstawie Porozumienia z dnia 11.09.2001 r., do Umowy nr PPL/AO/004/00 z dnia 15.03.2000 r., dotyczcej modernizacji systemu kontroli urzdze nawigacyjnych z powietrza typu CFIS.
Celem dokumentacji jest analiza dokumentu pt.: Instruction for Flight Inspection Reporting, Department of Transportation FAA, September 3, 1997, Order: 8240.36F zwanego dalej Podrcznikiem. Podrcznik ten nie był brany pod uwag przy ustalaniu zakresu prac objtych modernizacj zgodnie z wymienion wyej Umow.
Wymieniony powy-

ej system CFIS został zaprojektowany, wyprodukowany i wdro-

ony do
eksploatacji z wykorzystaniem wytycznych dotyczcych procedur pomiarowych wybranych urzdze nawigacyjnych z powietrza zawartych w wydaniu 3 Manual of testing of radio navigation aids Doc.8071 wydanego w roku 1972.
Zgodnie z treci Porozumienia zakres prac objtych Umow został rozszerzony o analiz wspomnianego wy-

ej Podrcznika. Celem analizy jest stwierdzenie i dyskusja ewentualnych niezgodnoci pomidzy przyjtymi rozwizaniami w systemie CFIS i wymaganiami stawianymi w Podrczniku. W kolejnych rozdziałach tego dokumentu zamieszczono omówienie tych zagadnie dla wybranych urzdze nawigacyjnych, tj.: VOR, ILS, DME, NDB.
Analiza zamieszczona w niniejszym opracowaniu zasadniczo dotyczy procedur i zagadnie zwizanych z procedurami pomiarowymi realizowanymi z powietrza. W szczególnoci pominito analiz dotyczc pomiarów naziemnych oraz procedur dotyczcych organizacji procesu pomiarowego, o ile procedury te nie musz mie do ich realizacji zapewnionej odpowiedniej funkcjonalnoci w systemie.
W Podrczniku opisano sposób korzystania z systemu do generowania raportów z inspekcji pomiarowych urzdze nawigacyjnych. W odró-

nieniu od systemu CFIS dane do raportów wprowadzane s rcznie. Moliwe jest równie-

rczne wypełnianie formularzy raportów. Podrczni podaje szczegóły zwizane z wprowadzanie danych oraz zagadnienia zwizane z procedurami archiwizacji raportów.

## 2. WYMAGANIA OGÓLNE

W rozdziale 2 zamieszczono wymaganie ogólne oraz definicje podstawowych poj. Komentarza wymagaj zapisy zawarte w p. 11.b, gdzie oprócz innych opisano sposób zaokrglania. System CFIS spełnia przedstawione tu wymogi, z wyjtkiem zaokrglania wielkoci poza tolerancj. Zgodnie z wymaganiami jeli obliczona wielko jest poza tolerancj, to nie nale-

y
jej zaokrgla . System CFFIS zaokrgla wszystkie wielkoci bez porównywania ich z granicznymi. Wprowadzenie tej zmiany wymaga uwzgldnienia w obliczeniach wartoci granicznych. Aktualnie system wielkoci graniczne tylko drukuje dla ułatwienia porównania ich z wynikami pomiaru. Wymaga to zmiany algorytmu drukowania raport kocowego i zmiany sposobu reprezentacji wyników analizy. Moliwa jest równie-

konieczno modyfikacji bazy danych. W p. 11.e wymagane jest sygnowanie ka-

dej strony numerem kolejnym i liczb stron w raporcie. Aktualnie system CFIS drukuje tylko numer strony. Drukowanie liczby stron jest mo-

liwe
po istotnej zmianie algorytmu realizacji raportów. Zmiana ta wymaga drukowania w dwóch przebiegach
W p.12.d wprowadza si wymaganie, aby na raportach widniały daty wszystkich pomiarów czstkowych. W systemie daty te s przechowywane i drukowane na raporcie kocowy.
Punkt 12.e wprowadza zapis o koniecznoci zaznaczania raportów czciowych i specjalnych, np. powypadkowych. Aktualnie system CFIS nie pozwala na wprowadzenie takich zapisów. Jeli taka potrzeba istnieje na raportach wydzielono pole Uwagi, gdzie tego rodzaje zapisy mo-

na
wprowadzi.

Formy protokołów

CAS 94-104 Łód ul. Obywatelska 137 | Strona: 2 | Dokument: P-00010602/Edycja: 11

## 3. FORMY PROTOKOŁÓW

W dodatku 1 i dalszych do Podrcznika zamieszczono blankiety raportów z inspekcji dla poszczególnych urzdze. Po ich szczegółowej analizie mo-

na stwierdzi, -

e wszystkie zawarte
na nich informacje s równie-

drukowane przez system CFIS. Zasadnicza ró-

nica polega na innej
postaci graficznej raportów. Wprowadzenie zaproponowanego tu układu graficznego wymaga bardzo istotnych zmian w algorytmach procedur generowania raportów i nie wydaje si uzasadnione.

Dodatek: Lista zalecanych zmian

CAS 94-104 Łód ul. Obywatelska 137 | Strona: 3 | Dokument: P-00010602/Edycja: 11

## 4. DODATEK: LISTA ZALECANYCH ZMIAN

Lp. | Modyfikacja | Opis | Status
1. | Metoda zaokrglania wielkoci poza tolerancj | 2 | Zalecenie
2. | Zmiana sposobu numeracji stron | 2 | Zalecenie
3. | Zaimplementowanie algorytmu zaznaczani raportów specjalnych | 2 | Zalecenie
4. | Zmiana formatu raportów na zgodny z Podrcznikiem | 3 | Nie zalecany
