CASMPostol/CFIS/docs/UserManual.pl/Rysunki/Config_nero.bmp

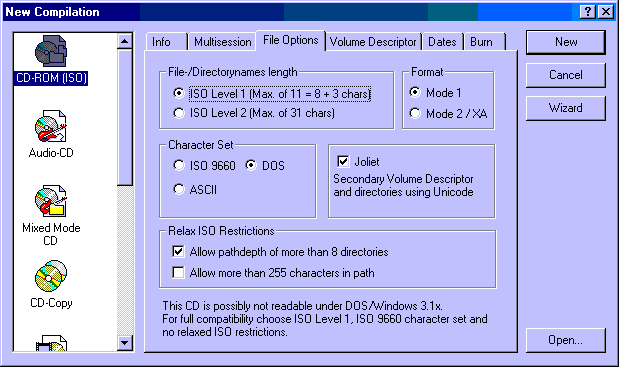
docs/UserManual.pl/Rysunki/Config_nero.bmp
