CASMPostol/CFIS/docs/UserManual.pl/Rysunki/Prg_glowny.bmp

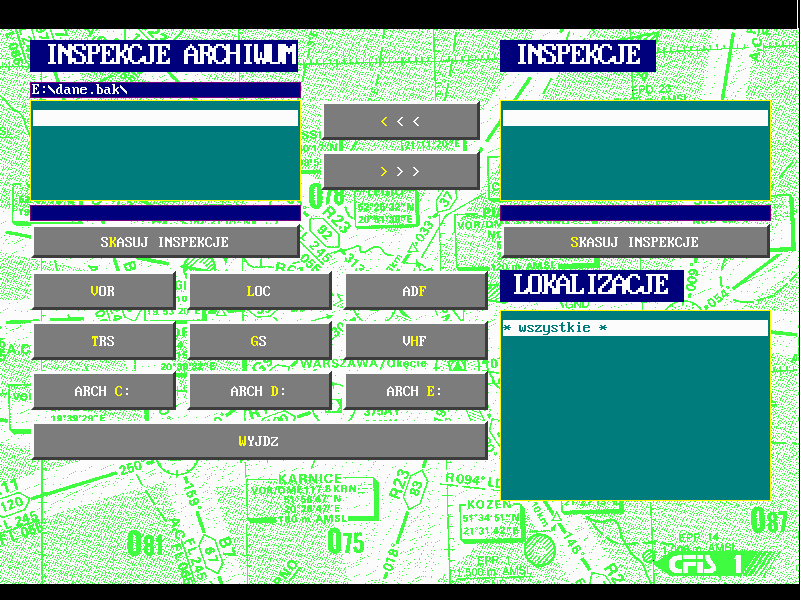
docs/UserManual.pl/Rysunki/Prg_glowny.bmp
