CASMPostol/CFIS/(list of files, drawings)

Other design files:
docs/UserManual.pl/P-00010301-DokumentacjaTechniczna/Schematy_elektryczne (ORCAD)/DESIGN/ADF/AC.DSN
docs/UserManual.pl/P-00010301-DokumentacjaTechniczna/Schematy_elektryczne (ORCAD)/DESIGN/ADF/AC_A.DSN
docs/UserManual.pl/P-00010301-DokumentacjaTechniczna/Schematy_elektryczne (ORCAD)/DESIGN/ADF/Ac_c.DSN
docs/UserManual.pl/P-00010301-DokumentacjaTechniczna/Schematy_elektryczne (ORCAD)/DESIGN/ADF/Ac_d.DSN
docs/UserManual.pl/P-00010301-DokumentacjaTechniczna/Schematy_elektryczne (ORCAD)/DESIGN/ADF/ACB.DSN
docs/UserManual.pl/P-00010301-DokumentacjaTechniczna/Schematy_elektryczne (ORCAD)/DESIGN/ADF/ACL1.DSN
docs/UserManual.pl/P-00010301-DokumentacjaTechniczna/Schematy_elektryczne (ORCAD)/DESIGN/ADF/Adf_a.DSN
docs/UserManual.pl/P-00010301-DokumentacjaTechniczna/Schematy_elektryczne (ORCAD)/DESIGN/ADF/ADFA.DSN
docs/UserManual.pl/P-00010301-DokumentacjaTechniczna/Schematy_elektryczne (ORCAD)/DESIGN/ADF/ADFACL.DSN
docs/UserManual.pl/P-00010301-DokumentacjaTechniczna/Schematy_elektryczne (ORCAD)/DESIGN/ADF/ADFB1CL.DSN
docs/UserManual.pl/P-00010301-DokumentacjaTechniczna/Schematy_elektryczne (ORCAD)/DESIGN/ADF/ADFB.DSN
docs/UserManual.pl/P-00010301-DokumentacjaTechniczna/Schematy_elektryczne (ORCAD)/DESIGN/ADF/ADFBCL.DSN
docs/UserManual.pl/P-00010301-DokumentacjaTechniczna/Schematy_elektryczne (ORCAD)/DESIGN/ADF/ADFCL_B.DSN
docs/UserManual.pl/P-00010301-DokumentacjaTechniczna/Schematy_elektryczne (ORCAD)/DESIGN/ADF/Kdf_b.DSN
docs/UserManual.pl/P-00010301-DokumentacjaTechniczna/Schematy_elektryczne (ORCAD)/DESIGN/ADF/Kdm_a.DSN
docs/UserManual.pl/P-00010301-DokumentacjaTechniczna/Schematy_elektryczne (ORCAD)/DESIGN/ADF/KDMA.DSN
docs/UserManual.pl/P-00010301-DokumentacjaTechniczna/Schematy_elektryczne (ORCAD)/DESIGN/ADF/KDMB.DSN
docs/UserManual.pl/P-00010301-DokumentacjaTechniczna/Schematy_elektryczne (ORCAD)/DESIGN/AUDIO/AUDIO.DSN
docs/UserManual.pl/P-00010301-DokumentacjaTechniczna/Schematy_elektryczne (ORCAD)/DESIGN/AUDIO/COMM.DSN
docs/UserManual.pl/P-00010301-DokumentacjaTechniczna/Schematy_elektryczne (ORCAD)/DESIGN/AUDIO/KAA.DSN
docs/UserManual.pl/P-00010301-DokumentacjaTechniczna/Schematy_elektryczne (ORCAD)/DESIGN/AUDIO/KMT112.DSN
docs/UserManual.pl/P-00010301-DokumentacjaTechniczna/Schematy_elektryczne (ORCAD)/DESIGN/AUDIO/KTR.DSN
docs/UserManual.pl/P-00010301-DokumentacjaTechniczna/Schematy_elektryczne (ORCAD)/DESIGN/AUDIO/VCL1.DSN
docs/UserManual.pl/P-00010301-DokumentacjaTechniczna/Schematy_elektryczne (ORCAD)/DESIGN/AUDIO/VCL2.DSN
docs/UserManual.pl/P-00010301-DokumentacjaTechniczna/Schematy_elektryczne (ORCAD)/DESIGN/AUDIO/VCL.DSN
docs/UserManual.pl/P-00010301-DokumentacjaTechniczna/Schematy_elektryczne (ORCAD)/DESIGN/AUDIO/VHFCL1.DSN
docs/UserManual.pl/P-00010301-DokumentacjaTechniczna/Schematy_elektryczne (ORCAD)/DESIGN/AUDIO/VHFCL.DSN
docs/UserManual.pl/P-00010301-DokumentacjaTechniczna/Schematy_elektryczne (ORCAD)/DESIGN/AUDIO/VHFCL_A.DSN
docs/UserManual.pl/P-00010301-DokumentacjaTechniczna/Schematy_elektryczne (ORCAD)/DESIGN/AUDIO/Vhfcl_b.DSN
docs/UserManual.pl/P-00010301-DokumentacjaTechniczna/Schematy_elektryczne (ORCAD)/DESIGN/CLOCK/CLOCK(1).DSN
docs/UserManual.pl/P-00010301-DokumentacjaTechniczna/Schematy_elektryczne (ORCAD)/DESIGN/CLOCK/CLOCK(2).DSN
docs/UserManual.pl/P-00010301-DokumentacjaTechniczna/Schematy_elektryczne (ORCAD)/DESIGN/CLOCK/CLOCK(3).DSN
docs/UserManual.pl/P-00010301-DokumentacjaTechniczna/Schematy_elektryczne (ORCAD)/DESIGN/CLOCK/CLOCK(4).DSN
docs/UserManual.pl/P-00010301-DokumentacjaTechniczna/Schematy_elektryczne (ORCAD)/DESIGN/CLOCK/CLOCK(5).DSN
docs/UserManual.pl/P-00010301-DokumentacjaTechniczna/Schematy_elektryczne (ORCAD)/DESIGN/CLOCK/CLOCK(6).DSN
docs/UserManual.pl/P-00010301-DokumentacjaTechniczna/Schematy_elektryczne (ORCAD)/DESIGN/CLOCK/CLOCK(7).DSN
docs/UserManual.pl/P-00010301-DokumentacjaTechniczna/Schematy_elektryczne (ORCAD)/DESIGN/CLOCK/Clock(8).DSN
docs/UserManual.pl/P-00010301-DokumentacjaTechniczna/Schematy_elektryczne (ORCAD)/DESIGN/CLOCK/CLOCK(8).OLB
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
