CASMPostol/CFIS/LOTNLIST.INI

[Lotniska]
Lotnisko_22=
Lotnisko_21=
Lotnisko_20=BYDGOSZCZ
Lotnisko_19=PAPI_EPWA_11
Lotnisko_18=PAPI_EPWA_33
Lotnisko_17=PAPI_EPBY_08
Lotnisko_16=SZCZECIN
Lotnisko_15=PAPI_EPSY_20
Lotnisko_14=SZYMANY
Lotnisko_13=PAPI_EPPO_11
Lotnisko_12=PAPI_EPSC_13
Lotnisko_11=PAPI_EPBY_26
Lotnisko_10=PAPI_EPWA_15
Lotnisko_9=PAPI_EPRZ_09
Lotnisko_8=PAPI_EPWA_29
Lotnisko_7=WROC�AW
Lotnisko_6=RZESZàW
Lotnisko_5=POZNAã
Lotnisko_4=KRAKàW
Lotnisko_3=KATOWICE
Lotnisko_2=GDAãSK
Lotnisko_1=WARSZAWA_33
Lotnisko_0=WARSZAWA_11
Ilosc=21

[WARSZAWA_11]
GPSLOC.Kat=0.00
GPSLOC.Wysokosc=0.00
GPSLOC.Odleglosc=0.00
GPSGS.Kat=0.00
GPSGS.Wysokosc=0.00
GPSGS.Odleglosc=0.00
DME.Dlugosc.DTysieczne=1228
DME.Dlugosc.Minuty=57
DME.Dlugosc.Stopnie=20
DME.Szerokosc.DTysieczne=2700
DME.Szerokosc.Minuty=10
DME.Szerokosc.Stopnie=52
Szerokosc.DTysieczne=6392
Dlugosc.DTysieczne=1167
Czestotliwosc=18
Dme=1
Identyfikator=WAS
Punkt.Ch.E=0.00
Punkt.Ch.D=0.00
Punkt.Ch.C=0.15
Punkt.Ch.B=0.58
Punkt.Ch.A=4.00
Marker.2=0.00
Marker.1=0.00
Marker.0=0.00
DME.Offset=0.00
DME.Odleglosc=0.00
DME.Azymut=0.00
Szerokosc.Sektora-A.Szeroki=4.91
Szerokosc.Sektora.N=4.20
Szerokosc.Sektora-A.Waski=3.49
Kat.GS=3.00
Szerokosc.GS=0.72
Pas.Koniec=0.05
Pas.Start=1.57
Kategoria=1
KierunekPasa=114
Deklinacja=-0.51
Teodolit.Odleglosc.LOC=0.00
Teodolit.Odleglosc.GS=0.00
Dlugosc.Minuty=59
Dlugosc.Stopnie=20
Szerokosc.Minuty=09
Szerokosc.Stopnie=52

[WARSZAWA_33]
DME.Dlugosc.DTysieczne=8430
DME.Dlugosc.Minuty=58
DME.Dlugosc.Stopnie=20
DME.Szerokosc.DTysieczne=1600
DME.Szerokosc.Minuty=09
DME.Szerokosc.Stopnie=52
Szerokosc.DTysieczne=8340
Dlugosc.DTysieczne=2498
Czestotliwosc=22
Dme=1
Identyfikator=WA
Punkt.Ch.E=0.00
Punkt.Ch.D=0.00
Punkt.Ch.C=0.00
Punkt.Ch.B=0.58
Punkt.Ch.A=4.00
Marker.2=0.00
Marker.1=0.00
Marker.0=0.00
DME.Offset=0.00
DME.Odleglosc=0.00
DME.Azymut=0.00
Szerokosc.Sektora-A.Szeroki=3.63
Szerokosc.Sektora.N=3.10
Szerokosc.Sektora-A.Waski=2.57
Kat.GS=2.95
Szerokosc.GS=0.72
Pas.Koniec=0.13
Pas.Start=2.12
Kategoria=2
KierunekPasa=331
Deklinacja=-0.75
Teodolit.Odleglosc.LOC=0.00
Teodolit.Odleglosc.GS=0.00
Dlugosc.Minuty=57
Dlugosc.Stopnie=20
Szerokosc.Minuty=10
Szerokosc.Stopnie=52

[GDAãSK]
DME.Dlugosc.DTysieczne=1073
DME.Dlugosc.Minuty=29
DME.Dlugosc.Stopnie=18
DME.Szerokosc.DTysieczne=3037
DME.Szerokosc.Minuty=22
DME.Szerokosc.Stopnie=54
Szerokosc.DTysieczne=9513
Dlugosc.DTysieczne=7693
Czestotliwosc=22
Dme=1
Identyfikator=GDA
Punkt.Ch.E=0.00
Punkt.Ch.D=0.00
Punkt.Ch.C=0.16
Punkt.Ch.B=0.58
Punkt.Ch.A=4.00
Marker.2=0.00
Marker.1=0.00
Marker.0=0.00
DME.Offset=0.00
DME.Odleglosc=0.00
DME.Azymut=0.00
Szerokosc.Sektora-A.Szeroki=4.45
Szerokosc.Sektora.N=3.80
Szerokosc.Sektora-A.Waski=3.15
Kat.GS=2.90
Szerokosc.GS=0.70
Pas.Koniec=0.23
Pas.Start=1.74
Kategoria=1
KierunekPasa=292
Deklinacja=-0.96
Teodolit.Odleglosc.LOC=200.00
Teodolit.Odleglosc.GS=0.00
Dlugosc.Minuty=26
Dlugosc.Stopnie=18
Szerokosc.Minuty=22
Szerokosc.Stopnie=54

[KATOWICE]
DME.Dlugosc.DTysieczne=0000
DME.Dlugosc.Minuty=00
DME.Dlugosc.Stopnie=0
DME.Szerokosc.DTysieczne=0000
DME.Szerokosc.Minuty=00
DME.Szerokosc.Stopnie=0
Szerokosc.DTysieczne=4582
Dlugosc.DTysieczne=2867
Czestotliwosc=18
Dme=0
Identyfikator=KAT
Punkt.Ch.E=0.00
Punkt.Ch.D=0.00
Punkt.Ch.C=0.16
Punkt.Ch.B=0.52
Punkt.Ch.A=4.24
Marker.2=4.24
Marker.1=0.52
Marker.0=0.00
DME.Offset=0.00
DME.Odleglosc=0.00
DME.Azymut=0.00
Szerokosc.Sektora-A.Szeroki=5.15
Szerokosc.Sektora.N=4.40
Szerokosc.Sektora-A.Waski=3.65
Kat.GS=2.90
Szerokosc.GS=0.70
Pas.Koniec=0.22
Pas.Start=1.51
Kategoria=1
KierunekPasa=270
Deklinacja=-0.21
Teodolit.Odleglosc.LOC=120.00
Teodolit.Odleglosc.GS=0.00
Dlugosc.Minuty=03
Dlugosc.Stopnie=19
Szerokosc.Minuty=28
Szerokosc.Stopnie=50

[KRAKàW]
DME.Dlugosc.DTysieczne=0000
DME.Dlugosc.Minuty=00
DME.Dlugosc.Stopnie=0
DME.Szerokosc.DTysieczne=0000
DME.Szerokosc.Minuty=00
DME.Szerokosc.Stopnie=0
Szerokosc.DTysieczne=4950
Dlugosc.DTysieczne=8812
Czestotliwosc=22
Dme=0
Identyfikator=KRW
Punkt.Ch.E=0.00
Punkt.Ch.D=0.00
Punkt.Ch.C=0.15
Punkt.Ch.B=0.59
Punkt.Ch.A=4.48
Marker.2=4.48
Marker.1=0.59
Marker.0=0.00
DME.Offset=0.00
DME.Odleglosc=0.00
DME.Azymut=0.00
Szerokosc.Sektora-A.Szeroki=5.59
Szerokosc.Sektora.N=4.78
Szerokosc.Sektora-A.Waski=3.97
Kat.GS=3.00
Szerokosc.GS=0.72
Pas.Koniec=0.13
Pas.Start=1.38
Kategoria=1
KierunekPasa=257
Deklinacja=-0.79
Teodolit.Odleglosc.LOC=180.00
Teodolit.Odleglosc.GS=0.00
Dlugosc.Minuty=45
Dlugosc.Stopnie=19
Szerokosc.Minuty=04
Szerokosc.Stopnie=50

[POZNAã]
DME.Dlugosc.DTysieczne=0000
DME.Dlugosc.Minuty=00
DME.Dlugosc.Stopnie=0
DME.Szerokosc.DTysieczne=0000
DME.Szerokosc.Minuty=00
DME.Szerokosc.Stopnie=0
Szerokosc.DTysieczne=5493
Dlugosc.DTysieczne=0918
Czestotliwosc=22
Dme=0
Identyfikator=POZ
Punkt.Ch.E=0.00
Punkt.Ch.D=0.00
Punkt.Ch.C=0.15
Punkt.Ch.B=0.81
Punkt.Ch.A=3.94
Marker.2=3.94
Marker.1=0.81
Marker.0=0.00
DME.Offset=0.00
DME.Odleglosc=0.00
DME.Azymut=0.00
Szerokosc.Sektora-A.Szeroki=5.03
Szerokosc.Sektora.N=4.30
Szerokosc.Sektora-A.Waski=3.57
Kat.GS=3.00
Szerokosc.GS=0.72
Pas.Koniec=0.18
Pas.Start=1.53
Kategoria=1
KierunekPasa=287
Deklinacja=-0.56
Teodolit.Odleglosc.LOC=0.00
Teodolit.Odleglosc.GS=0.00
Dlugosc.Minuty=48
Dlugosc.Stopnie=16
Szerokosc.Minuty=25
Szerokosc.Stopnie=52

[RZESZàW]
DME.Dlugosc.DTysieczne=9197
DME.Dlugosc.Minuty=01
DME.Dlugosc.Stopnie=22
DME.Szerokosc.DTysieczne=6603
DME.Szerokosc.Minuty=06
DME.Szerokosc.Stopnie=50
Szerokosc.DTysieczne=6162
Dlugosc.DTysieczne=7033
Czestotliwosc=22
Dme=1
Identyfikator=RZE
Punkt.Ch.E=0.00
Punkt.Ch.D=0.00
Punkt.Ch.C=0.16
Punkt.Ch.B=0.58
Punkt.Ch.A=4.00
Marker.2=0.00
Marker.1=0.00
Marker.0=0.00
DME.Offset=0.00
DME.Odleglosc=0.00
DME.Azymut=0.00
Szerokosc.Sektora-A.Szeroki=4.80
Szerokosc.Sektora.N=4.10
Szerokosc.Sektora-A.Waski=3.40
Kat.GS=2.90
Szerokosc.GS=0.70
Pas.Koniec=0.25
Pas.Start=1.60
Kategoria=1
KierunekPasa=271
Deklinacja=-0.19
Teodolit.Odleglosc.LOC=0.00
Teodolit.Odleglosc.GS=0.00
Dlugosc.Minuty=59
Dlugosc.Stopnie=21
Szerokosc.Minuty=06
Szerokosc.Stopnie=50

[WROC�AW]
GPSLOC.Kat=0.00
GPSLOC.Wysokosc=0.00
GPSLOC.Odleglosc=0.00
GPSGS.Kat=0.00
GPSGS.Wysokosc=0.00
GPSGS.Odleglosc=0.00
DME.Dlugosc.DTysieczne=5853
DME.Dlugosc.Minuty=53
DME.Dlugosc.Stopnie=16
DME.Szerokosc.DTysieczne=9372
DME.Szerokosc.Minuty=05
DME.Szerokosc.Stopnie=51
Szerokosc.DTysieczne=6223
Dlugosc.DTysieczne=6418
Czestotliwosc=22
Dme=1
Identyfikator=WRO
Punkt.Ch.E=0.00
Punkt.Ch.D=0.00
Punkt.Ch.C=0.15
Punkt.Ch.B=0.58
Punkt.Ch.A=4.00
Marker.2=0.00
Marker.1=0.00
Marker.0=0.00
DME.Offset=0.00
DME.Odleglosc=0.00
DME.Azymut=0.00
Szerokosc.Sektora-A.Szeroki=4.91
Szerokosc.Sektora.N=4.20
Szerokosc.Sektora-A.Waski=3.49
Kat.GS=3.00
Szerokosc.GS=0.72
Pas.Koniec=0.22
Pas.Start=1.57
Kategoria=1
KierunekPasa=295
Deklinacja=-0.95
Teodolit.Odleglosc.LOC=0.00
Teodolit.Odleglosc.GS=0.00
Dlugosc.Minuty=51
Dlugosc.Stopnie=16
Szerokosc.Minuty=06
Szerokosc.Stopnie=51

[PAPI_EPWA_29]
Szerokosc.DTysieczne=7722
Dlugosc.DTysieczne=6423
Czestotliwosc=0
Dme=0
Identyfikator=PAP
Punkt.Ch.E=0.00
Punkt.Ch.D=0.00
Punkt.Ch.C=0.00
Punkt.Ch.B=0.58
Punkt.Ch.A=4.00
Marker.2=4.00
Marker.1=0.58
Marker.0=0.00
DME.Offset=0.00
DME.Odleglosc=0.00
DME.Azymut=0.00
Szerokosc.Sektora-A.Szeroki=5.00
Szerokosc.Sektora.N=4.00
Szerokosc.Sektora-A.Waski=3.00
Kat.GS=3.00
Szerokosc.GS=0.72
Pas.Koniec=0.00
Pas.Start=0.00
Kategoria=1
KierunekPasa=292
Deklinacja=-3.00
Teodolit.Odleglosc.LOC=0.00
Teodolit.Odleglosc.GS=0.00
Dlugosc.Minuty=58
Dlugosc.Stopnie=20
Szerokosc.Minuty=09
Szerokosc.Stopnie=52

[PAPI_EPRZ_09]
Szerokosc.DTysieczne=6113
Dlugosc.DTysieczne=0927
Czestotliwosc=22
Dme=0
Identyfikator=PAP
Punkt.Ch.E=0.00
Punkt.Ch.D=0.00
Punkt.Ch.C=0.00
Punkt.Ch.B=0.58
Punkt.Ch.A=4.00
Marker.2=4.00
Marker.1=0.58
Marker.0=0.00
DME.Offset=0.00
DME.Odleglosc=0.00
DME.Azymut=0.00
Szerokosc.Sektora-A.Szeroki=4.80
Szerokosc.Sektora.N=4.10
Szerokosc.Sektora-A.Waski=3.40
Kat.GS=3.00
Szerokosc.GS=0.72
Pas.Koniec=0.00
Pas.Start=0.00
Kategoria=1
KierunekPasa=091
Deklinacja=-0.17
Teodolit.Odleglosc.LOC=0.00
Teodolit.Odleglosc.GS=0.00
Dlugosc.Minuty=00
Dlugosc.Stopnie=22
Szerokosc.Minuty=06
Szerokosc.Stopnie=50

[PAPI_EPWA_15]
Szerokosc.DTysieczne=7140
Dlugosc.DTysieczne=3550
Czestotliwosc=0
Dme=0
Identyfikator=PAP
Punkt.Ch.E=0.00
Punkt.Ch.D=0.00
Punkt.Ch.C=0.00
Punkt.Ch.B=0.58
Punkt.Ch.A=4.00
Marker.2=4.00
Marker.1=0.58
Marker.0=0.00
DME.Offset=0.00
DME.Odleglosc=0.00
DME.Azymut=0.00
Szerokosc.Sektora-A.Szeroki=5.00
Szerokosc.Sektora.N=4.00
Szerokosc.Sektora-A.Waski=3.00
Kat.GS=3.00
Szerokosc.GS=0.72
Pas.Koniec=0.00
Pas.Start=0.00
Kategoria=1
KierunekPasa=149
Deklinacja=-3.00
Teodolit.Odleglosc.LOC=0.00
Teodolit.Odleglosc.GS=0.00
Dlugosc.Minuty=57
Dlugosc.Stopnie=20
Szerokosc.Minuty=10
Szerokosc.Stopnie=52

[PAPI_EPBY_26]
DME.Dlugosc.DTysieczne=0000
DME.Dlugosc.Minuty=00
DME.Dlugosc.Stopnie=0
DME.Szerokosc.DTysieczne=0000
DME.Szerokosc.Minuty=00
DME.Szerokosc.Stopnie=0
Szerokosc.DTysieczne=9010
Dlugosc.DTysieczne=7638
Czestotliwosc=0
Dme=0
Identyfikator=PAP
Punkt.Ch.E=0.00
Punkt.Ch.D=0.00
Punkt.Ch.C=0.00
Punkt.Ch.B=0.58
Punkt.Ch.A=4.00
Marker.2=4.00
Marker.1=0.58
Marker.0=0.00
DME.Offset=0.00
DME.Odleglosc=0.00
DME.Azymut=0.00
Szerokosc.Sektora-A.Szeroki=5.00
Szerokosc.Sektora.N=4.00
Szerokosc.Sektora-A.Waski=3.00
Kat.GS=3.00
Szerokosc.GS=0.72
Pas.Koniec=0.00
Pas.Start=0.00
Kategoria=1
KierunekPasa=259
Deklinacja=-3.00
Teodolit.Odleglosc.LOC=0.00
Teodolit.Odleglosc.GS=0.00
Dlugosc.Minuty=59
Dlugosc.Stopnie=17
Szerokosc.Minuty=05
Szerokosc.Stopnie=53

[PAPI_EPSC_13]
Szerokosc.DTysieczne=5250
Dlugosc.DTysieczne=2753
Czestotliwosc=0
Dme=0
Identyfikator=PAP
Punkt.Ch.E=0.00
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
Kat.GS=3.00
Szerokosc.GS=0.72
Pas.Koniec=0.00
Pas.Start=0.00
Kategoria=1
KierunekPasa=079
Deklinacja=-3.00
Teodolit.Odleglosc.LOC=0.00
Teodolit.Odleglosc.GS=0.00
Dlugosc.DTysieczne=5565
Dlugosc.Minuty=57
Dlugosc.Stopnie=17
Szerokosc.DTysieczne=7153
Szerokosc.Minuty=05
Szerokosc.Stopnie=53



[PAPI_EPWA_33]
Czestotliwosc=0
Dme=0
Identyfikator=pap
Punkt.Ch.E=0.00
Punkt.Ch.D=0.00
Punkt.Ch.C=0.00
Punkt.Ch.B=0.58
Punkt.Ch.A=4.00
Marker.2=4.00
Marker.1=0.58
Marker.0=0.00
DME.Offset=0.00
DME.Odleglosc=0.00
DME.Azymut=0.00
Szerokosc.Sektora-A.Szeroki=5.00
Szerokosc.Sektora.N=4.00
Szerokosc.Sektora-A.Waski=3.00
Kat.GS=3.00
Szerokosc.GS=0.72
Pas.Koniec=0.00
Pas.Start=0.00
Kategoria=1
KierunekPasa=329
Deklinacja=-3.00
Teodolit.Odleglosc.LOC=0.00
Teodolit.Odleglosc.GS=0.00
Dlugosc.DTysieczne=8863
Dlugosc.Minuty=58
Dlugosc.Stopnie=20
Szerokosc.DTysieczne=9618
Szerokosc.Minuty=08
Szerokosc.Stopnie=52

[PAPI_EPWA_11]
DME.Dlugosc.DTysieczne=0000
DME.Dlugosc.Minuty=00
DME.Dlugosc.Stopnie=0
DME.Szerokosc.DTysieczne=0000
DME.Szerokosc.Minuty=00
DME.Szerokosc.Stopnie=0
Czestotliwosc=0
Dme=0
Identyfikator=pap
Punkt.Ch.E=0.00
Punkt.Ch.D=0.00
Punkt.Ch.C=0.00
Punkt.Ch.B=0.58
Punkt.Ch.A=4.00
Marker.2=4.00
Marker.1=0.58
Marker.0=0.00
DME.Offset=0.00
DME.Odleglosc=0.00
DME.Azymut=0.00
Szerokosc.Sektora-A.Szeroki=5.00
Szerokosc.Sektora.N=4.00
Szerokosc.Sektora-A.Waski=3.00
Kat.GS=3.00
Szerokosc.GS=0.72
Pas.Koniec=0.00
Pas.Start=0.00
Kategoria=1
KierunekPasa=112
Deklinacja=-3.00
Teodolit.Odleglosc.LOC=0.00
Teodolit.Odleglosc.GS=0.00
Dlugosc.DTysieczne=8028
Dlugosc.Minuty=56
Dlugosc.Stopnie=20
Szerokosc.DTysieczne=2885
Szerokosc.Minuty=10
Szerokosc.Stopnie=52


[BYDGOSZCZ]
Czestotliwosc=10
Dme=1
Identyfikator=BYD
Punkt.Ch.E=0.00
Punkt.Ch.D=0.00
Punkt.Ch.C=0.15
Punkt.Ch.B=0.58
Punkt.Ch.A=4.00
Marker.2=0.00
Marker.1=0.00
Marker.0=0.00
DME.Offset=0.00
DME.Dlugosc.DTysieczne=5228
DME.Dlugosc.Minuty=59
DME.Dlugosc.Stopnie=17
DME.Szerokosc.DTysieczne=8155
DME.Szerokosc.Minuty=05
DME.Szerokosc.Stopnie=53
Szerokosc.Sektora-A.Szeroki=4.91
Szerokosc.Sektora.N=4.20
Szerokosc.Sektora-A.Waski=3.49
Kat.GS=3.00
Szerokosc.GS=0.72
Pas.Koniec=0.23
Pas.Start=1.57
Kategoria=1
KierunekPasa=262
Deklinacja=-.06
Teodolit.Odleglosc.LOC=0.00
Teodolit.Odleglosc.GS=0.00
Dlugosc.DTysieczne=1797
Dlugosc.Minuty=57
Dlugosc.Stopnie=17
Szerokosc.DTysieczne=6835
Szerokosc.Minuty=05
Szerokosc.Stopnie=53
