CASMPostol/CFIS/KALIBRAC.INI

[LOC%MOD#0#]
Poprawka.B=  -0.11626
Poprawka.A=   0.00505
[GS%MOD#0#]
Poprawka.B=  -0.53210
Poprawka.A=   0.01157
[VOR.REF%MOD#0#]
Poprawka.B=  -0.10260
Poprawka.A=   0.00293
[VOR.VAR%MOD#0#]
Poprawka.B=  -0.09971
Poprawka.A=   0.00587
[SUBCAR%MOD#0#]
Poprawka.B=  -0.60258
Poprawka.A=   0.02152
[VOR.OMNIBEARING#0#]
Poprawka350.A= 350.02000
Poprawka340.A= 340.00000
Poprawka330.A= 330.02000
Poprawka320.A= 320.00000
Poprawka310.A= 310.03000
Poprawka300.A= 300.01000
Poprawka290.A= 289.99000
Poprawka280.A= 279.97000
Poprawka270.A= 270.00000
Poprawka260.A= 259.98000
Poprawka250.A= 249.96000
Poprawka240.A= 239.98000
Poprawka230.A= 229.92000
Poprawka220.A= 219.94000
Poprawka210.A= 209.97000
Poprawka200.A= 199.95000
Poprawka190.A= 189.97000
Poprawka180.A= 179.95000
Poprawka170.A= 169.98000
Poprawka160.A= 159.96000
Poprawka150.A= 149.94000
Poprawka140.A= 139.96000
Poprawka130.A= 129.99000
Poprawka120.A= 119.97000
Poprawka110.A= 109.99000
Poprawka100.A=  99.97000
Poprawka090.A=  89.95000
Poprawka080.A=  79.98000
Poprawka070.A=  69.96000
Poprawka060.A=  59.98000
Poprawka050.A=  50.00000
Poprawka040.A=  39.99000
Poprawka030.A=  30.01000
Poprawka020.A=  19.99000
Poprawka010.A=   9.97000
Poprawka000.A=   0.00000
[VOR.OMNIBEARING#1#]
Poprawka350.A= 349.89000
Poprawka340.A= 339.87000
Poprawka330.A= 329.85000
Poprawka320.A= 319.87000
Poprawka310.A= 309.85000
Poprawka300.A= 299.83000
Poprawka290.A= 289.86000
Poprawka280.A= 279.88000
Poprawka270.A= 269.86000
Poprawka260.A= 259.84000
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
<2>.A=2700.00000
<1>.A=   0.00000
<0>.A=-500.00000
[DME%REPLY_PK#1#]
<3>.A= 120.00000
<2>.A= 100.00000
<1>.A=  40.00000
<0>.A=   1.00000
[LOC.DEV#0#]
<6>.A=4192.00000
<5>.A=1402.00000
<4>.A= 844.00000
<3>.A=  -4.00000
<2>.A=-856.00000
<1>.A=-1422.00000
<0>.A=-4252.00000
[GS.DEV#0#]
<6>.A=-3169.88889
<5>.A=-881.00000
<4>.A=-469.00000
<3>.A= -19.00000
<2>.A= 411.00000
<1>.A= 821.00000
<0>.A=3098.77778
[LOC.DEV#1#]
<6>.A=4238.00000
<5>.A=1418.00000
<4>.A= 854.00000
<3>.A=   2.00000
<2>.A=-854.00000
<1>.A=-1416.00000
<0>.A=-4226.00000
[GS.DEV#1#]
<6>.A=-3123.66667
<5>.A=-857.00000
<4>.A=-449.00000
<3>.A=  -5.00000
<2>.A= 427.00000
<1>.A= 831.00000
<0>.A=3075.44444
[Auto_Cal_Delays]
MkrAgc_delay=  10.00000
GsAgc_delay=  10.00000
VorAgc_delay=  20.00000
Omnibearing_delay=  15.00000
SubcarPrcMod_delay=  10.00000
VorVarPrcMod_delay=  10.00000
VorRefPrcMod_delay=  10.00000
GsPrcMod_delay=  10.00000
LocPrcMod_delay=  10.00000
GsDev_delay=  10.00000
LocDev_delay=  10.00000
[AGC_Coefficient_Tab#0#]
Znaczenie= AGCMkr=<0>, AGCLocVor=<1>, AGCGs=<2>
<2>.A=   1.03000
<1>.A=   1.51000
<0>.A=   1.51000
[AGC_Coefficient_Tab#1#]
Znaczenie= AGCMkr=<0>, AGCLocVor=<1>, AGCGs=<2>
<2>.A=   1.03000
<1>.A=   1.51000
<0>.A=   1.37000
