CASMPostol/CFIS/DGH.INI

[MODforLOCa]
ModuleType=AnalogInput
Address=1
Channel=First

[SFLGforNAVa]
ModuleType=DigitalInput
Address=1
Channel=First

[MODforGSa]
ModuleType=AnalogInput
Address=2
Channel=First

[SFLGforGSa]
ModuleType=DigitalInput
Address=2
Channel=First

[VARa]
ModuleType=AnalogInput
Address=3
Channel=First

[REFa]
ModuleType=AnalogInput
Address=4
Channel=First

[SUBCARa]
ModuleType=AnalogInput
Address=5
Channel=First

[NAVaAudio]
ModuleType=DigitalInput
Address=5
Channel=First

[NAVaON]
ModuleType=DigitalOutput
Address=5
Channel=First

[AGCforNAVa]
ModuleType=AnalogInput
Address=6
Channel=First

[InnMKRa]
ModuleType=DigitalInput
Address=6
Channel=First

[ILSaEnergize]
ModuleType=DigitalOutput
Address=6
Channel=First

[AGCforGSa]
ModuleType=AnalogInput
Address=7
Channel=First

[MidMKRa]
ModuleType=DigitalInput
Address=7
Channel=First

[AGCforMKRa]
ModuleType=AnalogInput
Address=8
Channel=First

[OutMKRa]
ModuleType=DigitalInput
Address=8
Channel=First

[MKRaHiLoSense]
ModuleType=DigitalOutput
Address=8
Channel=First

[CockpitDisplaySP]
ModuleType=DigitalOutput
Address=9
Channel=First

[CockpitDisplayD1]
ModuleType=DigitalOutput
Address=9
Channel=First

[CockpitDisplayD2]
ModuleType=DigitalOutput
Address=9
Channel=First

[CockpitDisplayD3]
ModuleType=DigitalOutput
Address=9
Channel=First

[CockpitDisplayD4]
ModuleType=DigitalOutput
Address=9
Channel=First

[CockpitDisplayMsg]
ModuleType=DigitalOutput
Address=9
Channel=First

[AGCforDMEa]
ModuleType=AnalogInput
Address=:
Channel=First

[DME_SRCa]
ModuleType=DigitalInput
Address=:
Channel=First

[SQUITTERforDMEa]
ModuleType=AnalogInput
Address=;
Channel=First

[DME_MEMa]
ModuleType=DigitalInput
Address=;
Channel=First

[REPLYforDMEa]
ModuleType=AnalogInput
Address=<
Channel=First

[DMEaAudio]
ModuleType=DigitalInput
Address=<
Channel=First

[DMEDistanceA]
ModuleType=DigitalInput
Address==
Channel=First

[DMEaTune]
ModuleType=DigitalOutput
Address=>
Channel=First

[AGCforADFa]
ModuleType=AnalogInput
Address=?
Channel=First

[ADFaAudio]
ModuleType=DigitalInput
Address=?
Channel=First

[ADFaON]
ModuleType=DigitalOutput
Address=?
Channel=First

[SINforADFa]
ModuleType=AnalogInput
Address=@
Channel=First

[COSforADFa]
ModuleType=AnalogInput
Address=A
Channel=First

[Altimeter]
ModuleType=DigitalInput
Address=B
Channel=First

[ConsoleCPGSNeedle]
ModuleType=AnalogOutput
Address=C
Channel=First

[ConsoleCPLOCNeedle]
ModuleType=AnalogOutput
Address=D
Channel=First

[AGCforCOMa]
ModuleType=AnalogInput
Address=E
Channel=First

[COMaAudio]
ModuleType=DigitalInput
Address=E
Channel=First

[MODforLOCb]
ModuleType=AnalogInput
Address=1
Channel=Second

[SFLGforNAVb]
ModuleType=DigitalInput
Address=1
Channel=Second

[MODforGSb]
ModuleType=AnalogInput
Address=2
Channel=Second

[SFLGforGSb]
ModuleType=DigitalInput
Address=2
Channel=Second

[VARb]
ModuleType=AnalogInput
Address=3
Channel=Second

[REFb]
ModuleType=AnalogInput
Address=4
Channel=Second

[SUBCARb]
ModuleType=AnalogInput
Address=5
Channel=Second

[NAVbAudio]
ModuleType=DigitalInput
Address=5
Channel=Second

[NAVbON]
ModuleType=DigitalOutput
Address=5
Channel=Second

[AGCforNAVb]
ModuleType=AnalogInput
Address=6
Channel=Second

[InnMKRb]
ModuleType=DigitalInput
Address=6
Channel=Second

[ILSbEnergize]
ModuleType=DigitalOutput
Address=6
Channel=Second

[AGCforGSb]
ModuleType=AnalogInput
Address=7
Channel=Second

[MidMKRb]
ModuleType=DigitalInput
Address=7
Channel=Second

[AGCforMKRb]
ModuleType=AnalogInput
Address=8
Channel=Second

[OutMKRb]
ModuleType=DigitalInput
Address=8
Channel=Second

[MKRbHiLoSense]
ModuleType=DigitalOutput
Address=8
Channel=Second

[AGCforDMEb]
ModuleType=AnalogInput
Address=:
Channel=Second

[DME_SRCb]
ModuleType=DigitalInput
Address=:
Channel=Second

[SQUITTERforDMEb]
ModuleType=AnalogInput
Address=;
Channel=Second

[DME_MEMb]
ModuleType=DigitalInput
Address=;
Channel=Second

[REPLYforDMEb]
ModuleType=AnalogInput
Address=<
Channel=Second

[DMEbAudio]
ModuleType=DigitalInput
Address=<
Channel=Second

[DMEDistanceB]
ModuleType=DigitalInput
Address==
Channel=Second

[DMEbTune]
ModuleType=DigitalOutput
Address=>
Channel=Second

[AGCforADFb]
ModuleType=AnalogInput
Address=?
Channel=Second

[ADFbAudio]
ModuleType=DigitalInput
Address=?
Channel=Second

[ADFbON]
ModuleType=DigitalOutput
Address=?
Channel=Second

[SINforADFb]
ModuleType=AnalogInput
Address=@
Channel=Second

[COSforADFb]
ModuleType=AnalogInput
Address=A
Channel=Second

[CockpitCPGSNeedle]
ModuleType=AnalogOutput
Address=C
Channel=Second

[CockpitCPLOCNeedle]
ModuleType=AnalogOutput
Address=D
Channel=Second

[SwitchCntrl]
ModuleType=DigitalOutput
Address=F
Channel=First

[Terminator]
ModuleType=
Address=
Channel=First
