CASMPostol/CFIS/SYM_DB.SRC/LOTNLIST.INI

[Lotniska]
Lotnisko_6=
Lotnisko_5=
Lotnisko_4=
Lotnisko_3=POZNAN
Lotnisko_2=RZESZOW
Lotnisko_1=WARSZAWA.330
Ilosc=4
Lotnisko_0=WARSZAWA.113
[WARSZAWA.113]
DME.Dlugosc.DTysieczne=0000
DME.Dlugosc.Minuty=00
DME.Dlugosc.Stopnie=0
DME.Szerokosc.DTysieczne=0000
DME.Szerokosc.Minuty=00
DME.Szerokosc.Stopnie=0
Dlugosc.DTysieczne=0000
Szerokosc.DTysieczne=0000
Czestotliwosc=18
Dme=0
Identyfikator=WAR
Punkt.Ch.E=1.30
Punkt.Ch.D=0.50
Punkt.Ch.C=0.00
Punkt.Ch.B=2.50
Punkt.Ch.A=4.00
Marker.2=6.00
Marker.1=2.50
Marker.0=0.00
DME.Offset=0.00
DME.Odleglosc=0.00
DME.Azymut=0.00
Szerokosc.Sektora-A.Szeroki=4.50
Szerokosc.Sektora.N=3.00
Szerokosc.Sektora-A.Waski=3.50
Kat.GS=3.00
Szerokosc.GS=0.70
Pas.Koniec=0.20
Pas.Start=2.00
Kategoria=3
KierunekPasa=180
Deklinacja=0.00
Teodolit.Odleglosc.LOC=0.00
Teodolit.Odleglosc.GS=0.00
Dlugosc.Setne=00
Dlugosc.Minuty=00
Dlugosc.Stopnie=21
Szerokosc.Setne=00
Szerokosc.Minuty=10
Szerokosc.Stopnie=52
[WARSZAWA.330]
DME.Dlugosc.DTysieczne=0000
DME.Dlugosc.Minuty=57
DME.Dlugosc.Stopnie=20
DME.Szerokosc.DTysieczne=0000
DME.Szerokosc.Minuty=10
DME.Szerokosc.Stopnie=52
Dlugosc.DTysieczne=0000
Szerokosc.DTysieczne=0000
Czestotliwosc=22
Dme=1
Identyfikator=WRW
Punkt.Ch.E=1.90
Punkt.Ch.D=0.50
Punkt.Ch.C=0.16
Punkt.Ch.B=0.52
Punkt.Ch.A=3.52
Marker.2=3.52
Marker.1=0.52
Marker.0=0.00
DME.Offset=0.00
DME.Odleglosc=0.00
DME.Azymut=0.00
Szerokosc.Sektora-A.Szeroki=3.63
Szerokosc.Sektora.N=3.10
Szerokosc.Sektora-A.Waski=2.57
Kat.GS=3.00
Szerokosc.GS=3.10
Pas.Koniec=0.13
Pas.Start=2.12
Kategoria=3
KierunekPasa=330
Deklinacja=-3.00
Teodolit.Odleglosc.LOC=0.00
Teodolit.Odleglosc.GS=0.00
Dlugosc.Setne=21
Dlugosc.Minuty=57
Dlugosc.Stopnie=20
Szerokosc.Setne=85
Szerokosc.Minuty=10
Szerokosc.Stopnie=52
[RZESZOW]
Czestotliwosc=22
Dme=0
Identyfikator=RZ
Punkt.Ch.E=1.10
Punkt.Ch.D=0.20
Punkt.Ch.C=0.16
Punkt.Ch.B=0.65
Punkt.Ch.A=3.78
Marker.2=3.78
Marker.1=0.65
Marker.0=0.10
DME.Offset=0.00
DME.Odleglosc=0.00
DME.Azymut=0.00
Szerokosc.Sektora-A.Szeroki=4.80
Szerokosc.Sektora.N=4.10
Szerokosc.Sektora-A.Waski=3.40
Kat.GS=3.00
Szerokosc.GS=3.00
Pas.Koniec=0.26
Pas.Start=1.60
Kategoria=1
KierunekPasa=268
Deklinacja=-3.00
Teodolit.Odleglosc.LOC=0.00
Teodolit.Odleglosc.GS=0.00
Dlugosc.Setne=78
Dlugosc.Minuty=59
Dlugosc.Stopnie=21
Szerokosc.Setne=64
Szerokosc.Minuty=06
Szerokosc.Stopnie=50
[ .]
Czestotliwosc=0
Dme=0
Identyfikator=***
Punkt.Ch.E=0.00
Punkt.Ch.D=0.00
Punkt.Ch.C=0.00
Punkt.Ch.B=0.00
Punkt.Ch.A=0.00
Marker.2=0.00
Marker.1=0.00
Marker.0=0.00
DME.Offset=0.00
DME.Odleglosc=0.00
DME.Azymut=0.00
Szerokosc.Sektora-A.Szeroki=0.00
Szerokosc.Sektora.N=0.00
Szerokosc.Sektora-A.Waski=0.00
Kat.GS=0.00
Szerokosc.GS=0.00
Pas.Koniec=0.00
Pas.Start=0.00
Kategoria=0
KierunekPasa=000
Deklinacja=0.00
Teodolit.Odleglosc.LOC=0.00
Teodolit.Odleglosc.GS=0.00
Dlugosc.Setne=00
Dlugosc.Minuty=00
Dlugosc.Stopnie=0
Szerokosc.Setne=00
Szerokosc.Minuty=00
Szerokosc.Stopnie=0
[POZNAN]
Czestotliwosc=22
Dme=0
Identyfikator=POZ
Punkt.Ch.E=1.30
Punkt.Ch.D=0.20
Punkt.Ch.C=0.20
Punkt.Ch.B=0.81
Punkt.Ch.A=3.94
Marker.2=3.94
Marker.1=0.81
Marker.0=0.20
DME.Offset=0.00
DME.Odleglosc=0.00
DME.Azymut=0.00
Szerokosc.Sektora-A.Szeroki=5.03
Szerokosc.Sektora.N=4.30
Szerokosc.Sektora-A.Waski=3.57
Kat.GS=3.00
Szerokosc.GS=3.00
Pas.Koniec=0.20
Pas.Start=1.53
Kategoria=1
KierunekPasa=107
Deklinacja=-3.00
Teodolit.Odleglosc.LOC=0.00
Teodolit.Odleglosc.GS=0.00
Dlugosc.Setne=28
Dlugosc.Minuty=48
Dlugosc.Stopnie=16
Szerokosc.Setne=31
Szerokosc.Minuty=25
Szerokosc.Stopnie=52
