CASMPostol/CFIS/(commit log)

2020-05-08 Import the source code. #2
    - import Rel 2.42
    [XMS.OBJ]
2020-05-08 Import the source code. #2
    - import Rel 3.14
    [ADFANGLE.OBJ, AG.OBJ, AH.OBJ, AL.OBJ, ALTINTER.OBJ, AN.OBJ, ARINC.OBJ, AT.OBJ]
2020-05-08 Import the source code. #2
    - import Rel 3.15
    [ADFANGLE.OBJ, AG.OBJ, AH.OBJ, AL.OBJ, ALTINTER.OBJ, AN.OBJ, ARINC.OBJ, AT.OBJ]
2020-05-08 Import the source code. #2
    - import Rel 3.17
    [XMS.OBJ]
2020-05-09 Setup repository #1
    - improved README.md
    - added use manual
    - added additional files
    [AC.DSN, AC.SCH, ACB.DSN, ACB.SCH, ACB_A.SCH, ACL.SCH, ACL1.DSN, ACL1.SCH]
